orpaltech/dreamstalker/hardware/images/PRO/v2.2/PXL_20260126_130624400.jpg

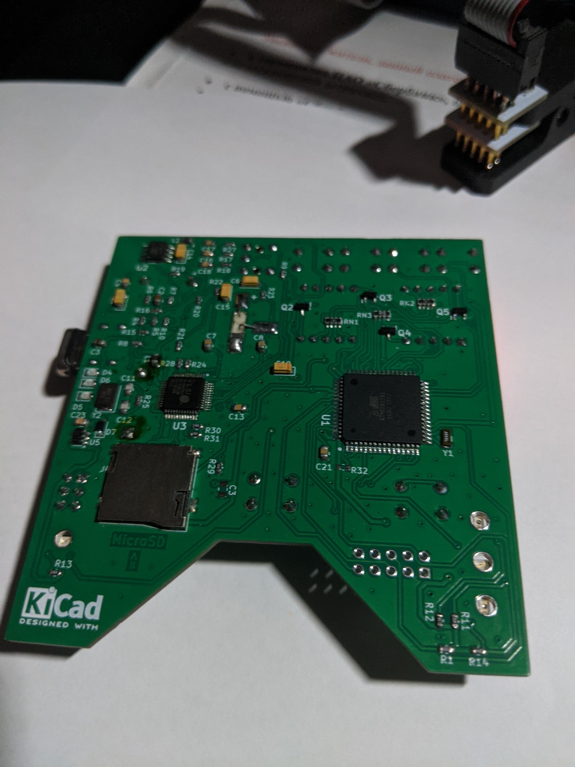
hardware/images/PRO/v2.2/PXL_20260126_130624400.jpg
