orpaltech/dreamstalker/README.md

# dreamstalker

This device is designed to assist with lucid dreaming. The idea comes from this site: https://smartelectron.ru/projects/pribor-dlya-osoznannyh-snovidenij-dreamstalker-pro.
