orpaltech/dreamstalker/hardware/images/PRO/v2.2/PXL_20260126_130629635.jpg

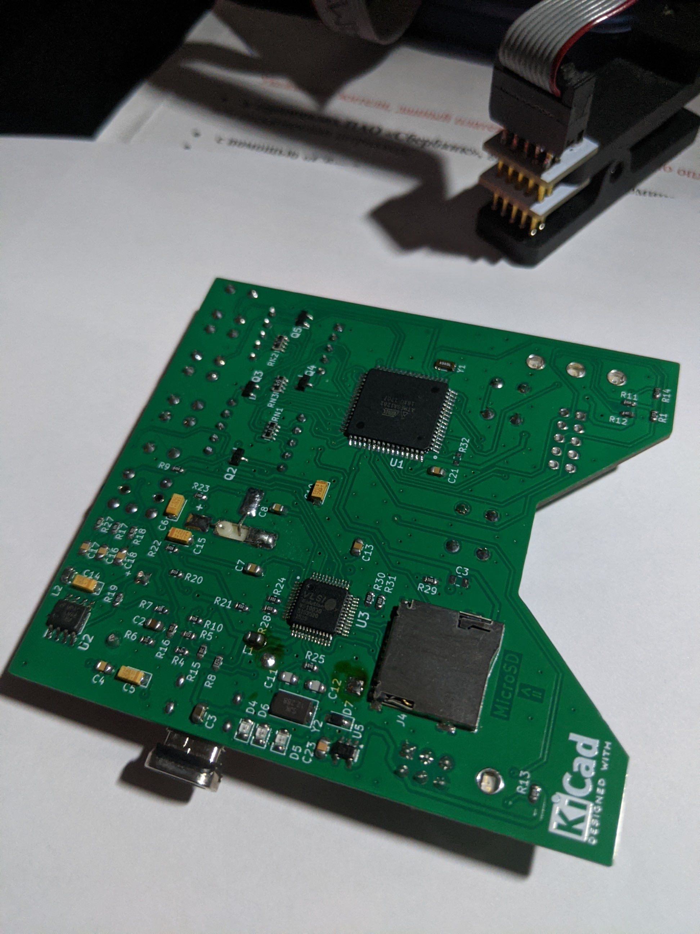
hardware/images/PRO/v2.2/PXL_20260126_130629635.jpg
