orpaltech/dreamstalker/tools/qtdreamflowmanager/images/about.png

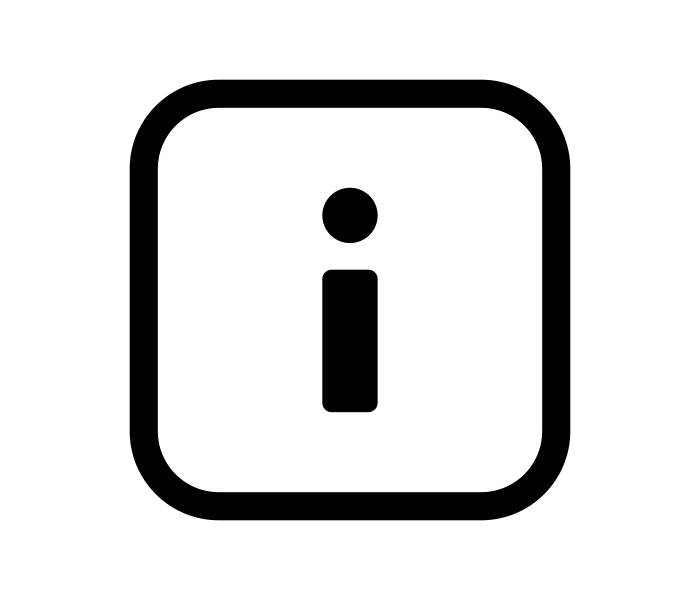
tools/qtdreamflowmanager/images/about.png
