orpaltech/dreamstalker/tools/qtdreamflowmanager/images/application-exit.png

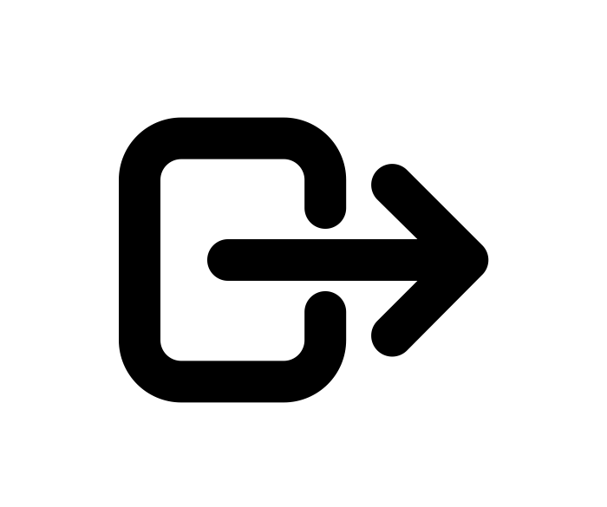
tools/qtdreamflowmanager/images/application-exit.png
