orpaltech/dreamstalker/tools/qtdreamflowmanager/images/line-chart.png

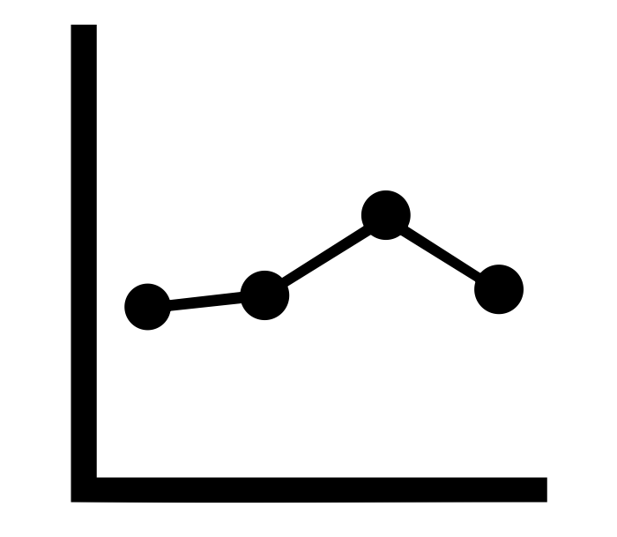
tools/qtdreamflowmanager/images/line-chart.png
