orpaltech/dreamstalker/tools/qtdreamflowmanager/images/load-from-device.png

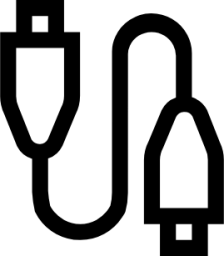
tools/qtdreamflowmanager/images/load-from-device.png
