orpaltech/dreamstalker/hardware/kicad/PRO/Dreamstalker-PRO-v2/Dreamstalker-PRO-v2.kicad_pcb

## KiCad design hardware/kicad/PRO/Dreamstalker-PRO-v2/Dreamstalker-PRO-v2.kicad_pcb (2026-08-15)

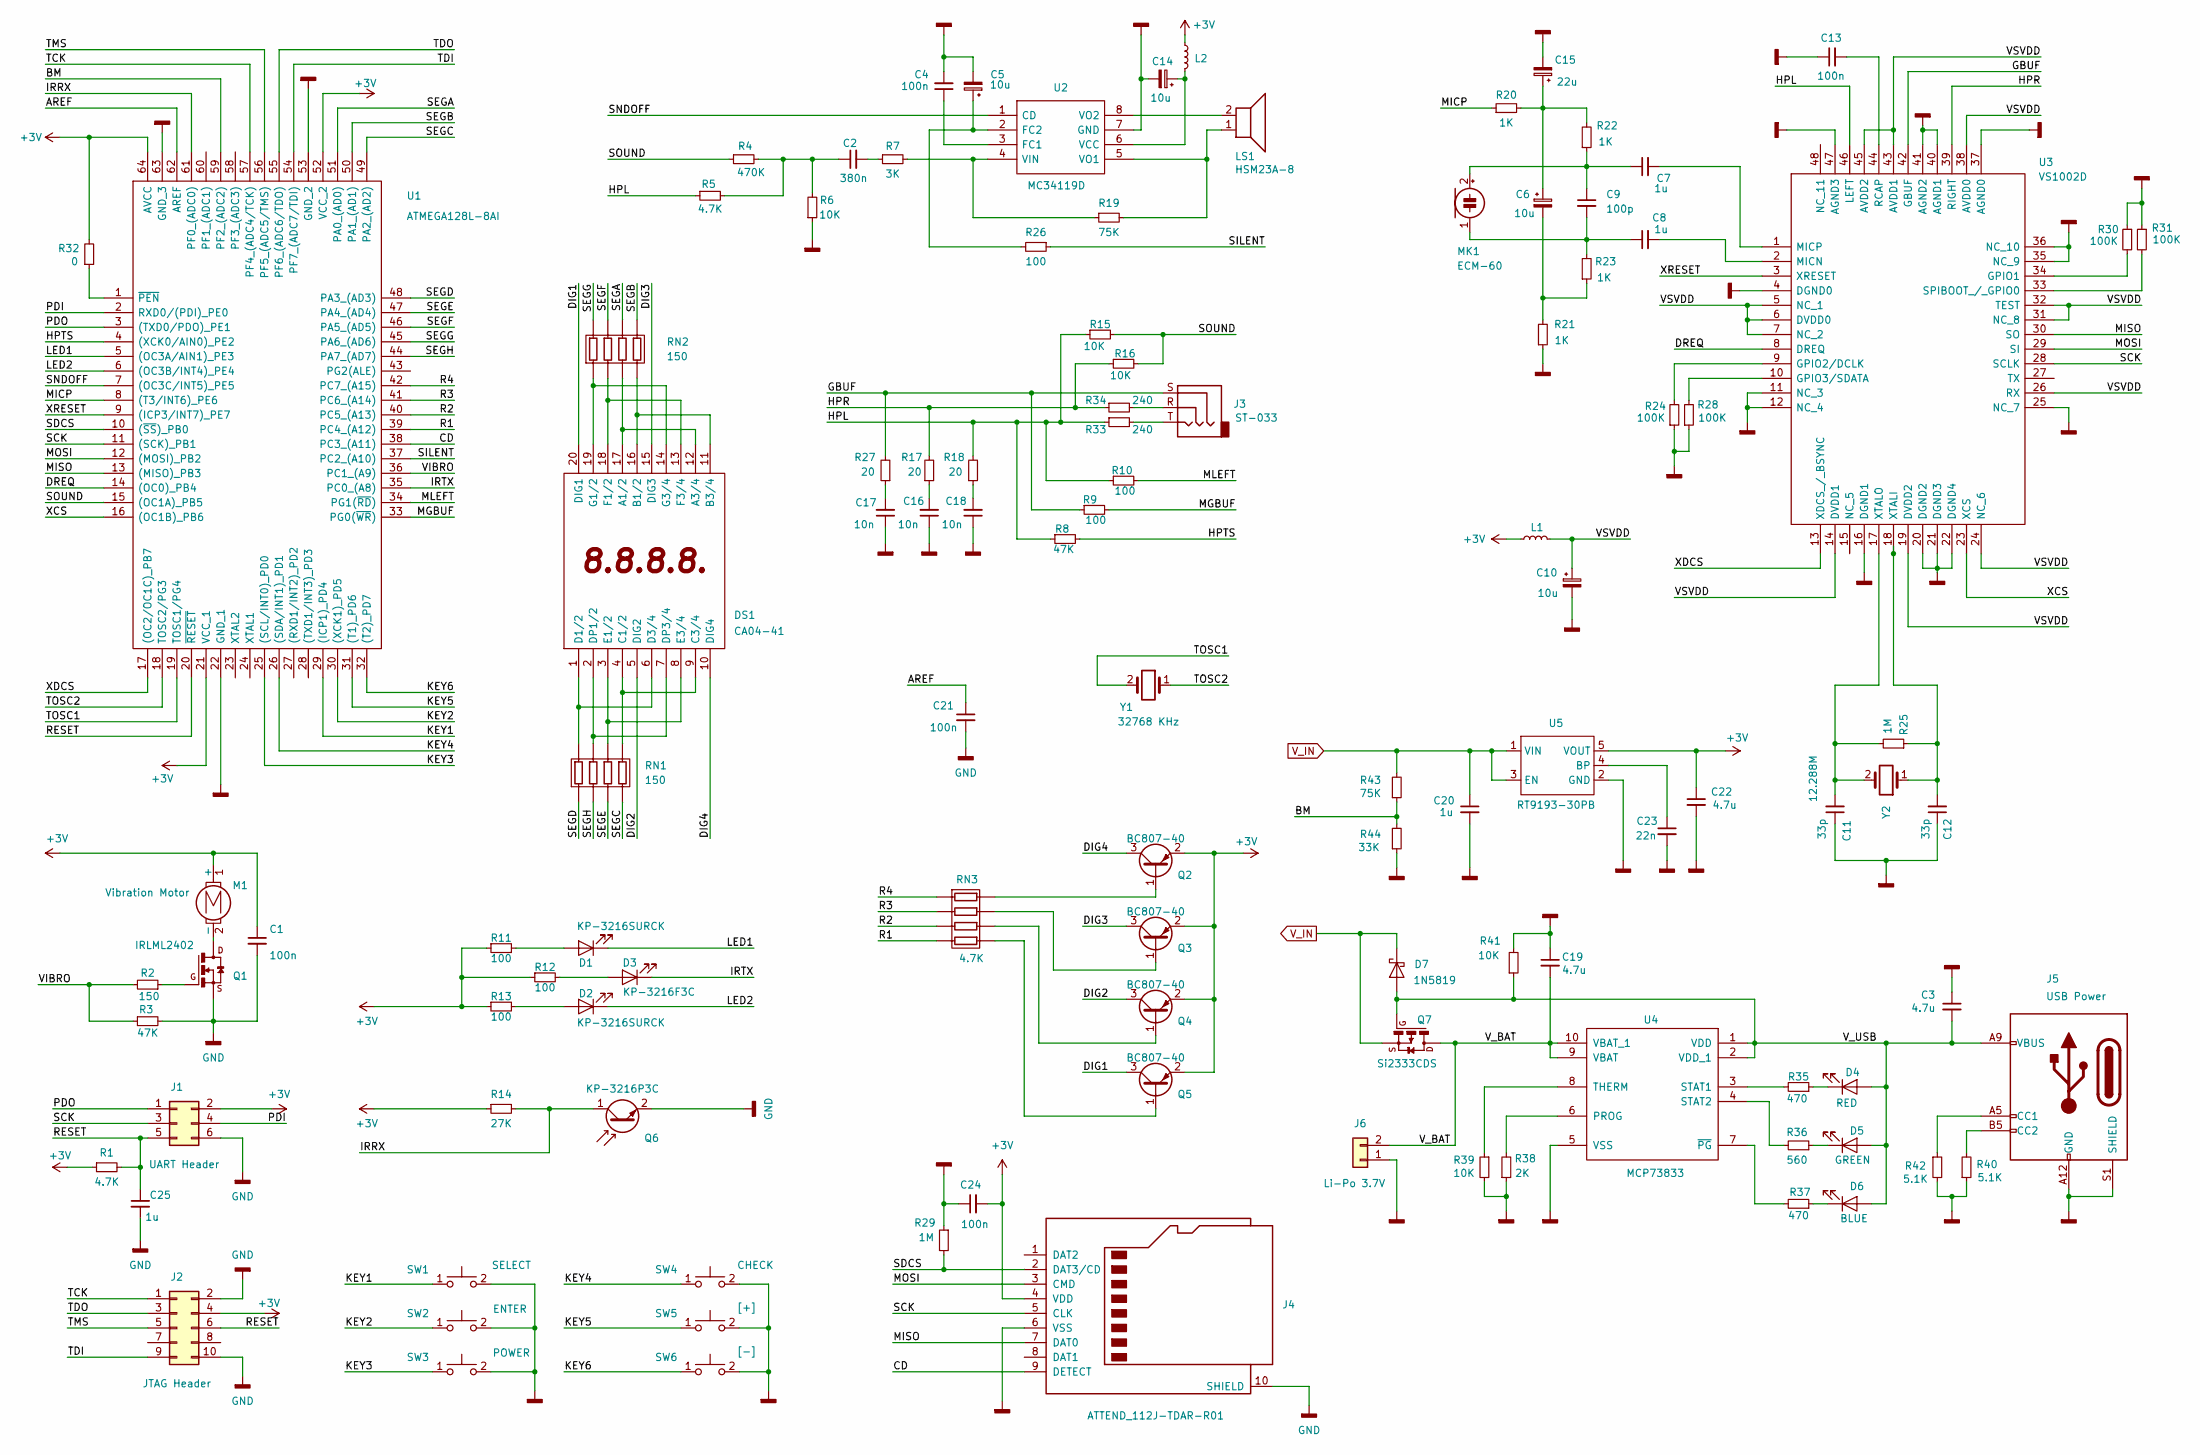
[picture p10: schematic Dreamstalker-PRO-v2.kicad_sch, Dreamstalker PRO]

Parts:
C1, C4, C13, C21, C24: 100n; C_0805_2012Metric
C2: 380n; C_0805_2012Metric
C3, C19, C22: 4.7u; C_0805_2012Metric
C5, C6, C10, C14: 10u; CP_EIA-3216-18_Kemet-A
C7, C8, C20, C25: 1u; C_0805_2012Metric
C9: 100p; C_0805_2012Metric
C11, C12: 33p; C_0805_2012Metric
C15: 22u; CP_EIA-3216-18_Kemet-A
C16, C17, C18: 10n; C_0805_2012Metric
C23: 22n; C_0805_2012Metric
D1, D2: KP-3216SURCK; LEDC3216X110N-TH
D3: KP-3216F3C; LEDC3216X110N-TH
D4: RED; LED_0805_2012Metric
D5: GREEN; LED_0805_2012Metric
D6: BLUE; LED_0805_2012Metric
D7: 1N5819; D_SOD-323_HandSoldering
DS1: CA04-41; Manufacturer_Part_Number CA04-41
J1: UART Header; PinHeader_2x03_P2.54mm_Vertical
J2: JTAG Header; PinHeader_2x05_P2.54mm_Vertical
J3: ST-033; DCI_Phone_Jack_3.5mm_ST-033
J4: ATTEND_112J-TDAR-R01; Manufacturer_Part_Number 112J-TDAR-R01
J5: USB Power; USB_C_Receptacle_GCT_USB4125-xx-x_6P_TopMnt_Horizontal
J6: Li-Po 3.7V; JST_PH_B2B-PH-K_1x02_P2.00mm_Vertical
L1, L2: L_Small; L_0805_2012Metric
LS1: HSM23A-8; Buzzer_23x11.5RM10
M1: Vibration Motor; VIBRO-MOTOR_SMD
MK1: ECM-60; JININ_ELECTRET_CONDENSER_MICROPHONE_ECM-60
Q1: IRLML2402; SOT95P237X112-3N
Q2, Q3, Q4, Q5: BC807-40; SOT95P230X110-3N
Q6: KP-3216P3C; LEDC3216X130N-TH
Q7: Si2333CDS; SOT-23
R1, R5: 4.7K; R_0603_1608Metric
R2: 150; R_0603_1608Metric
R3, R8: 47K; R_0603_1608Metric
R4: 470K; R_0603_1608Metric
R6, R15, R16, R39, R41: 10K; R_0603_1608Metric
R7: 3K; R_0603_1608Metric
R9, R10, R11, R12, R13, R26: 100; R_0603_1608Metric
R14: 27K; R_0603_1608Metric
R17, R18, R27: 20; R_0603_1608Metric
R19, R43: 75K; R_0603_1608Metric
R20, R21, R22, R23: 1K; R_0603_1608Metric
R24, R28, R30, R31: 100K; R_0603_1608Metric
R25, R29: 1M; R_0603_1608Metric
R32: 0; R_0603_1608Metric
R33, R34: 240; R_0603_1608Metric
R35, R37: 470; R_0603_1608Metric
R36: 560; R_0603_1608Metric
R38: 2K; L_0603_1608Metric
R40, R42: 5.1K; R_0603_1608Metric
R44: 33K; R_0603_1608Metric
RN1, RN2: 150; R_Array_Convex_4x0603
RN3: 4.7K; R_Array_Convex_4x0603
SW1: SELECT; SW_PUSH_6mm
SW2: ENTER; SW_PUSH_6mm
SW3: POWER; SW_PUSH_6mm
SW4: CHECK; SW_PUSH_6mm
SW5: [+]; SW_PUSH_6mm
SW6: [-]; SW_PUSH_6mm
U1: ATMEGA128L-8AI; QFP80P1600X1600X120-64N; Manufacturer_Part_Number ATMEGA128L-8AI
U2: MC34119D; SOIC127P600X175-8N; Manufacturer_Part_Number MC34119D
U3: VS1002D; QFP50P900X900X160-48N; Manufacturer_Part_Number VS1002D
U4: MCP73833; SOP50P490X110-10N; Manufacturer_Part_Number MCP73833-FCI/UN
U5: RT9193-30PB; SOT-23-5; Manufacturer_Part_Number RT9193
Y1: 32768 KHz; Crystal_SMD_3215-2Pin_3.2x1.5mm
Y2: 12.288M; Crystal_SMD_5032-2Pin_5.0x3.2mm

Connections:
+3V: C1.1, C22.1, C24.2, J1.2, J2.4, J4.4 (VDD), L1.1, L2.1, M1.1 (+), Q2.2 (E), Q3.2 (E), Q4.2 (E), Q5.2 (E), R1.1, R11.1, R12.1, R13.1, R14.1, R32.2, U1.21 (VCC_1), U1.52 (VCC_2), U1.64 (AVCC), U5.5 (VOUT)
/AREF: C21.1, U1.62 (AREF)
/BM: R43.1, R44.2, U1.59 (PF2_(ADC2))
/CD: J4.9 (DETECT), U1.38 (PC3_(A11))
/DIG1: DS1.20 (DIG1), Q5.3 (C)
/DIG2: DS1.5 (DIG2), Q4.3 (C)
/DIG3: DS1.15 (DIG3), Q3.3 (C)
/DIG4: DS1.10 (DIG4), Q2.3 (C)
/DREQ: U1.14 ((OC0)_PB4), U3.8 (DREQ)
/GBUF: J3.S, R9.1, R27.2, U3.42 (GBUF)
/HPL: R5.1, R8.1, R10.1, R15.1, R18.2, R33.1, U3.46 (LEFT)
/HPR: R16.1, R17.2, R34.1, U3.39 (RIGHT)
/HPTS: R8.2, U1.4 ((XCK0/AIN0)_PE2)
/IRRX: Q6.1 (C), R14.2, U1.61 (PF0_(ADC0))
/IRTX: D3.1 (K), U1.35 (PC0_(A8))
/KEY1: SW1.1, U1.29 ((ICP1)_PD4)
/KEY2: SW2.1, U1.30 ((XCK1)_PD5)
/KEY3: SW3.1, U1.25 ((SCL/INT0)_PD0)
/KEY4: SW4.1, U1.26 ((SDA/INT1)_PD1)
/KEY5: SW5.1, U1.31 ((T1)_PD6)
/KEY6: SW6.1, U1.32 ((T2)_PD7)
/LED1: D1.1 (K), U1.5 ((OC3A/AIN1)_PE3)
/LED2: D2.1 (K), U1.6 ((OC3B/INT4)_PE4)
/MGBUF: R9.2, U1.33 (PG0(~WR))
/MICP: R20.1, U1.8 ((T3/INT6)_PE6)
/MISO: J4.7 (DAT0), U1.13 ((MISO)_PB3), U3.30 (SO)
/MLEFT: R10.2, U1.34 (PG1(~RD))
/MOSI: J4.3 (CMD), U1.12 ((MOSI)_PB2), U3.29 (SI)
/PDI: J1.4, U1.2 (RXD0/(PDI)_PE0)
/PDO: J1.1, U1.3 ((TXD0/PDO)_PE1)
/R1: RN3.4 (R4.1), U1.39 (PC4_(A12))
/R2: RN3.3 (R3.1), U1.40 (PC5_(A13))
/R3: RN3.2 (R2.1), U1.41 (PC6_(A14))
/R4: RN3.1 (R1.1), U1.42 (PC7_(A15))
/RESET: C25.1, J1.5, J2.6, R1.2, U1.20 (~RESET)
/SCK: J1.3, J4.5 (CLK), U1.11 ((SCK)_PB1), U3.28 (SCLK)
/SDCS: J4.2 (DAT3/CD), R29.2, U1.10 ((~SS)_PB0)
/SEGA: RN2.6 (R3.2), U1.51 (PA0_(AD0))
/SEGB: RN2.5 (R4.2), U1.50 (PA1_(AD1))
/SEGC: RN1.4 (R4.1), U1.49 (PA2_(AD2))
/SEGD: RN1.1 (R1.1), U1.48 (PA3_(AD3))
/SEGE: RN1.3 (R3.1), U1.47 (PA4_(AD4))
/SEGF: RN2.7 (R2.2), U1.46 (PA5_(AD5))
/SEGG: RN2.8 (R1.2), U1.45 (PA6_(AD6))
/SEGH: RN1.2 (R2.1), U1.44 (PA7_(AD7))
/SILENT: R26.1, U1.37 (PC2_(A10))
/SNDOFF: U1.7 ((OC3C/INT5)_PE5), U2.1 (CD)
/SOUND: R4.1, R15.2, R16.2, U1.15 ((OC1A)_PB5)
/TCK: J2.1, U1.57 (PF4_(ADC4/TCK))
/TDI: J2.9, U1.54 (PF7_(ADC7/TDI))
/TDO: J2.3, U1.55 (PF6_(ADC6/TDO))
/TMS: J2.5, U1.56 (PF5_(ADC5/TMS))
/TOSC1: U1.19 (TOSC1/PG4), Y1.2
/TOSC2: U1.18 (TOSC2/PG3), Y1.1
/VIBRO: R2.2, R3.1, U1.36 (PC1_(A9))
/VSVDD: C10.1, L1.2, U3.5 (NC_1), U3.6 (DVDD0), U3.7 (NC_2), U3.14 (DVDD1), U3.19 (DVDD2), U3.24 (NC_6), U3.26 (RX), U3.31 (NC_8), U3.32 (TEST), U3.38 (AVDD0), U3.43 (AVDD1), U3.45 (AVDD2)
/V_BAT: C19.2, J6.2, Q7.3 (D), U4.9 (VBAT), U4.10 (VBAT_1)
/V_USB: C3.2, D4.2 (A), D5.2 (A), D6.2 (A), D7.2 (A), J5.A9 (VBUS), J5.B9 (VBUS), Q7.1 (G), R41.1, U4.1 (VDD), U4.2 (VDD_1)
/XCS: U1.16 ((OC1B)_PB6), U3.23 (XCS)
/XDCS: U1.17 ((OC2/OC1C)_PB7), U3.13 (XDCS_/_BSYNC)
/XRESET: U1.9 ((ICP3/INT7)_PE7), U3.3 (XRESET)
GND: C1.2, C3.1, C4.2, C5.2, C10.2, C11.1, C12.1, C13.1, C14.2, C15.2, C16.1, C17.1, C18.1, C19.1, C20.2, C21.2, C22.2, C23.2, C24.1, C25.2, J1.6, J2.2, J2.10, J4.6 (VSS), J4.10 (SHIELD), J5.A12 (GND), J5.B12 (GND), J5.S1 (SHIELD), J6.1, Q1.2 (S), Q6.2 (E), R3.2, R6.1, R21.1, R24.1, R28.1, R29.1, R30.1, R31.1, R38.1, R39.2, R40.1, R41.2, R42.2, R44.1, SW1.2, SW2.2, SW3.2, SW4.2, SW5.2, SW6.2, U1.22 (GND_1), U1.53 (GND_2), U1.63 (GND_3), U2.7 (GND), U3.4 (DGND0), U3.11 (NC_3), U3.12 (NC_4), U3.16 (DGND1), U3.20 (DGND2), U3.21 (DGND3), U3.22 (DGND4), U3.25 (NC_7), U3.35 (NC_9), U3.36 (NC_10), U3.37 (AGND0), U3.40 (AGND1), U3.41 (AGND2), U3.47 (AGND3), U4.5 (VSS), U5.2 (GND)
unnamed: C2.1, R4.2, R5.2, R6.2
unnamed: C2.2, R7.1
unnamed: C6.2, R21.2, R23.1
unnamed: C6.1, C15.1, R20.2, R22.2
unnamed: C16.2, R17.1
unnamed: C17.2, R27.1
unnamed: C18.2, R18.1
unnamed: D1.2 (A), R11.2
unnamed: D2.2 (A), R13.2
unnamed: D3.2 (A), R12.2
unnamed: D4.1 (K), R35.1
unnamed: D5.1 (K), R36.1
unnamed: D6.1 (K), R37.1
unnamed: DS1.12 (A3/4), DS1.17 (A1/2), RN2.3 (R3.1)
unnamed: DS1.11 (B3/4), DS1.16 (B1/2), RN2.4 (R4.1)
unnamed: DS1.4 (C1/2), DS1.9 (C3/4), RN1.5 (R4.2)
unnamed: DS1.1 (D1/2), DS1.6 (D3/4), RN1.8 (R1.2)
unnamed: DS1.2 (DP1/2), DS1.7 (DP3/4), RN1.7 (R2.2)
unnamed: DS1.3 (E1/2), DS1.8 (E3/4), RN1.6 (R3.2)
unnamed: DS1.13 (F3/4), DS1.18 (F1/2), RN2.2 (R2.1)
unnamed: DS1.14 (G3/4), DS1.19 (G1/2), RN2.1 (R1.1)
unnamed: J3.R, R34.2
unnamed: J3.T, R33.2
unnamed: J5.A5 (CC1), R42.1
unnamed: J5.B5 (CC2), R40.2
unnamed: M1.2 (-), Q1.3 (D)
unnamed: C7.1, C9.1, MK1.2 (+), R22.1
unnamed: C8.1, C9.2, MK1.1 (-), R23.2
unnamed: Q1.1 (G), R2.1
unnamed: Q2.1 (B), RN3.8 (R1.2)
unnamed: Q3.1 (B), RN3.7 (R2.2)
unnamed: Q4.1 (B), RN3.6 (R3.2)
unnamed: Q5.1 (B), RN3.5 (R4.2)
unnamed: R32.1, U1.1 (~PEN)
unnamed: C4.1, U2.3 (FC1)
unnamed: C5.1, R26.2, U2.2 (FC2)
unnamed: C14.1, L2.2, U2.6 (VCC)
unnamed: R7.2, R19.1, U2.4 (VIN)
unnamed: LS1.1, R19.2, U2.5 (VO1)
unnamed: LS1.2, U2.8 (VO2)
unnamed: R30.2, U3.34 (GPIO1)
unnamed: R24.2, U3.9 (GPIO2/DCLK)
unnamed: R28.2, U3.10 (GPIO3/SDATA)
unnamed: C8.2, U3.2 (MICN)
unnamed: C7.2, U3.1 (MICP)
unnamed: C13.2, U3.44 (RCAP)
unnamed: R31.2, U3.33 (SPIBOOT_/_GPIO0)
unnamed: C12.2, R25.1, U3.18 (XTALI), Y2.1
unnamed: C11.2, R25.2, U3.17 (XTALO), Y2.2
unnamed: R38.2, U4.6 (PROG)
unnamed: R35.2, U4.3 (STAT1)
unnamed: R36.2, U4.4 (STAT2)
unnamed: R39.1, U4.8 (THERM)
unnamed: R37.2, U4.7 (~PG)
unnamed: C23.1, U5.4 (BP)
V_IN: C20.1, D7.1 (K), Q7.2 (S), R43.2, U5.1 (VIN), U5.3 (EN)

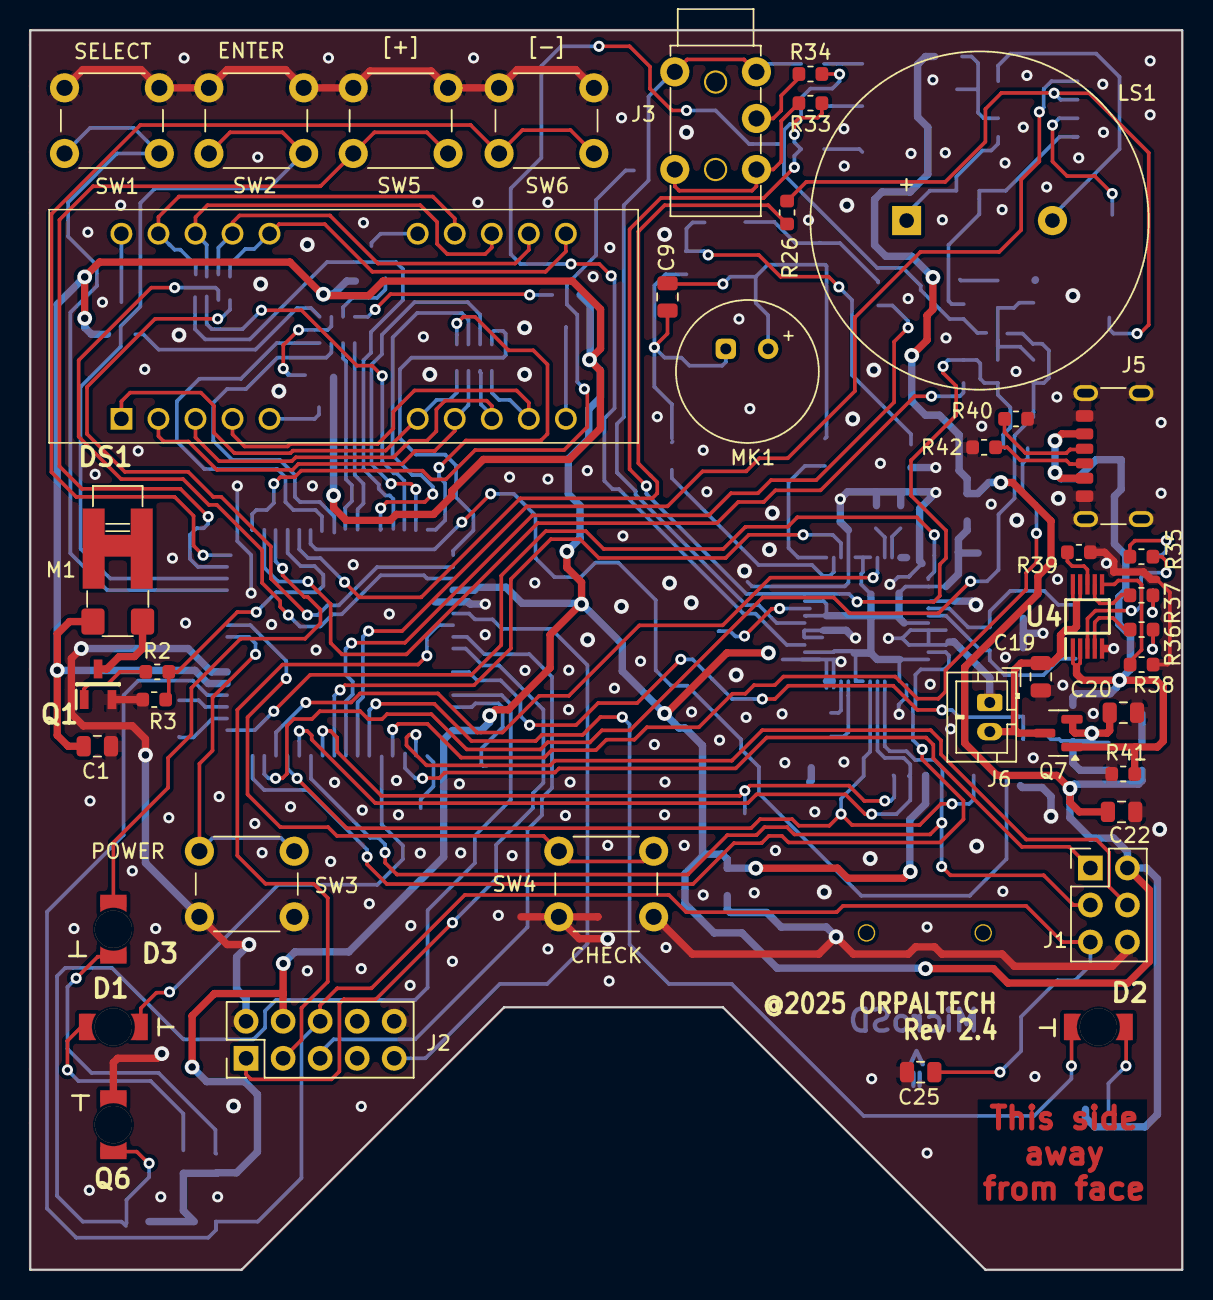
[picture p11: board Dreamstalker-PRO-v2.kicad_pcb from above]

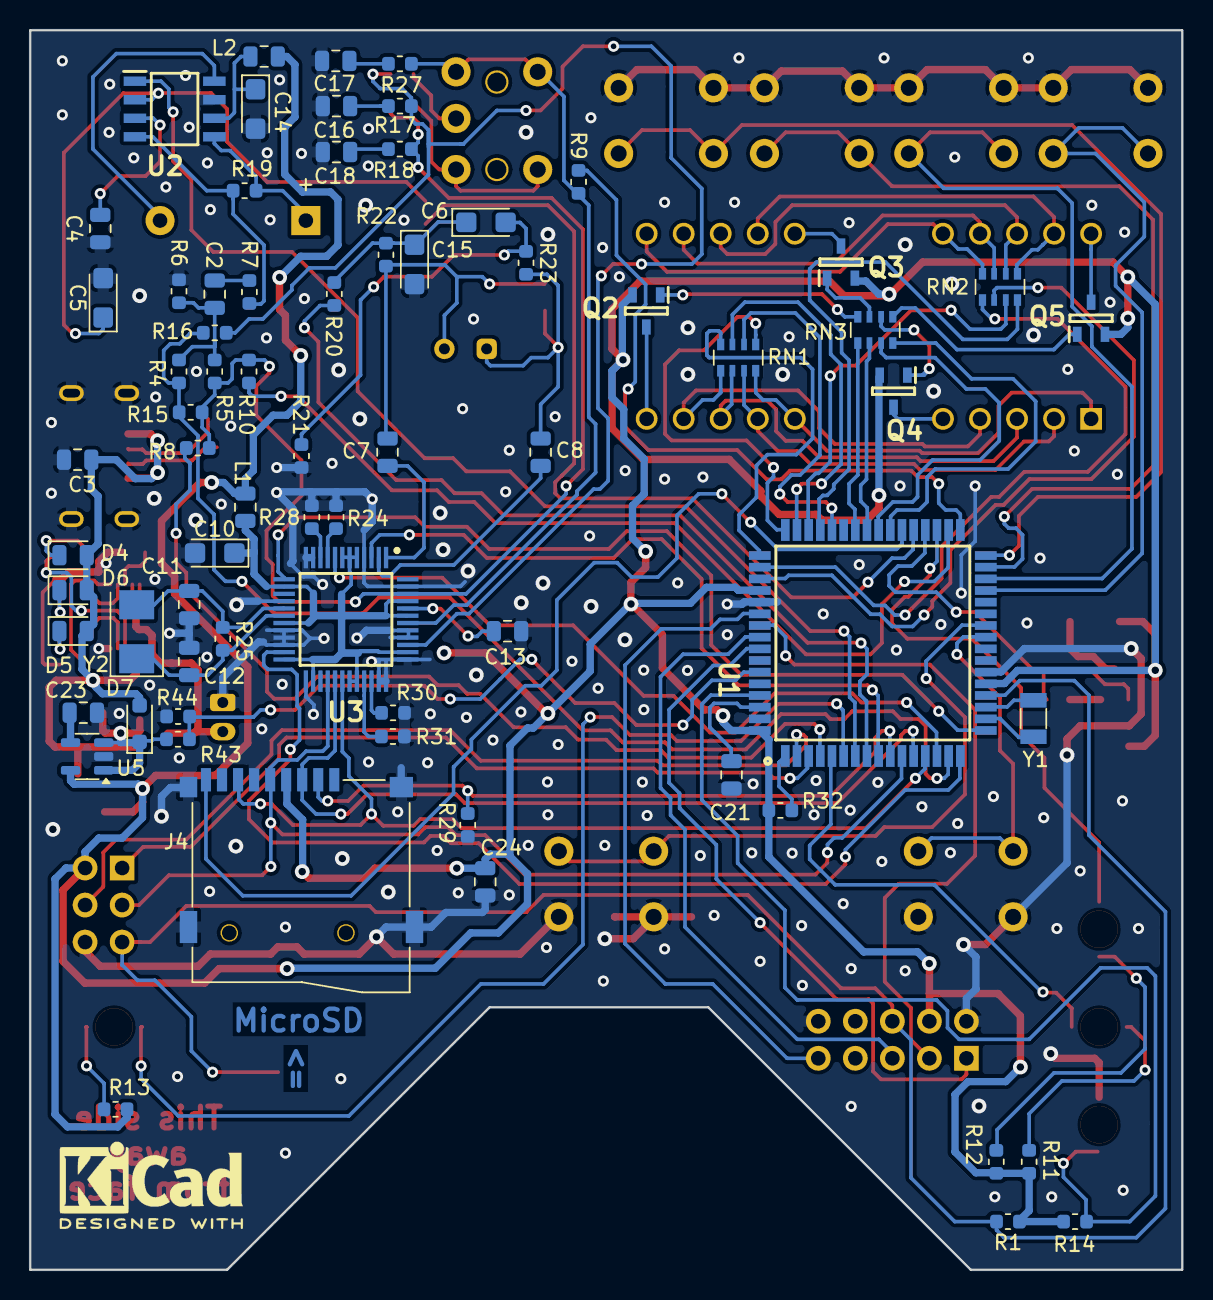
[picture p12: board Dreamstalker-PRO-v2.kicad_pcb from below]

Board: 2 copper layers, 79.0 x 85.0 mm, 111 parts (70 on the bottom side), 118 nets.
