orpaltech/dreamstalker/firmware/avrdreamstalkerpro/src/main.cpp

/*
 * This file is part of the AVR Dreamstalker software
 * (https://github.com/orpaltech/dreamstalker).
 *
 * Copyright (c) 2013-2026	ORPAL Technologies, Inc.
 *
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
 * You should have received a copy of the GNU General Public License
 * along with this program. If not, see <http://www.gnu.org/licenses/>.
 */

#include "ds_driver.h"

/*-----------------------------------------------------------------------*/
// put function declarations here:

/*-----------------------------------------------------------------------*/
void setup()
{
  auto drv = ds::Driver::get();

  // put your setup code here, to run once

  if (! drv->init ())
    return;

  if (! drv->start () )
  {
    // Handle the critical error
    drv->reboot_on_key ();
  }
}

/*-----------------------------------------------------------------------*/
void loop()
{
  auto drv = ds::Driver::get();

  drv->process ();

  /* End of app loop */
  _NOP ();
}
