orpaltech/dreamstalker/firmware/avrdreamstalkerpro/src/ds_driver.cpp

/*
 * This file is part of the AVR Dreamstalker software
 * (https://github.com/orpaltech/dreamstalker).
 *
 * Copyright (c) 2013-2025	ORPAL Technologies, Inc.
 *
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
 * You should have received a copy of the GNU General Public License
 * along with this program. If not, see <http://www.gnu.org/licenses/>.
 */

#include <Arduino.h>

#include <avr/io.h>
#include <compat/ina90.h>
#include <util/atomic.h>

#include "ds_driver.h"
#include "ds_config.h"
#include "ds_rtclock.h"
#include "display/ds_display.h"
#include "display/ds_disp_msgs.h"
#include "sound/ds_sound.h"
#include "sound/ds_codec.h"
#include "ds_remdetect.h"
#include "ds_battery.h"
#include "input/ds_keybrd.h"
#include "ds_appmenu.h"
#include "ds_sqwave.h"
#include "ds_sysclock.h"
#include "ds_vibro.h"
#include "ds_remhints.h"
#include "ds_sdfat.h"

using namespace avr::core;

/*-----------------------------------------------------------------------*/

/*
 * Defines the key to exit from sleep mode
 */
#define KEY_EXIT_SLEEP  KEY_POWER

namespace ds
{
/*-----------------------------------------------------------------------*/
void key_tone (bool wait = false)
{
  uint16_t duration = 80;
  Tonegen::get()->beep ( duration, 3, 6, Config::get()->get_volume_level ());
  
  if ( wait ) {
    SysClock::get()->wait (duration);
  }
}


/*-----------------------------------------------------------------------*/
Driver *Driver::get()
{
  static Driver instance;
  return &instance;
}

/*-----------------------------------------------------------------------*/
void Driver::alarm_clock_callback (void *context)
{
  Driver *pdrv = static_cast<Driver *>(context);

  pdrv->on_alarm_clock ();
}

void Driver::wakeup_timer_callback (void *context)
{
  Driver *pdrv = static_cast<Driver *>(context);

  pdrv->on_wakeup_timer ();
}

void Driver::remd_callback (void *context, remd::remd_event_type_t event, uint16_t arg)
{
  Driver *pdrv = static_cast<Driver *>(context);

  if ( pdrv->is_remd_check () ) {

    // REMD testing mode 

    if ( event == remd::REMD_EVENT_MOVE ) {
      Tonegen::get()->beep(50, 4, 7, Config::get()->get_volume_level ());
    }

  }
  else {
    
    // REMD lucid dreaming mode

    if ( event == remd::REMD_EVENT_REM ) {
      pdrv->on_remd_event_rem( arg );
    }
  }
}

/*-----------------------------------------------------------------------*/
#if RUN_TEST_MODE

bool Driver::begin (void)
{
  delay(600); /* Let power stabilize */

  set_mode ( OPM_NONE );

  RTClock::get()->init();
  SysClock::get()->init();
  Display::get()->init();
  Keyboard::get()->init ();
  AppMenu::get()->init();
  SquareWave::get()->init();
  Leds::get()->init();
  VibroMotor::get()->init();
  Sound::get()->init ();
  REMDetect::get()->init();
  BatteryMonitor::get()->init();

  return true;
}

void Driver::end (void)
{
  // Implement , if needed
}

bool Driver::start (void)
{
  set_mode ( OPM_NORMAL );    /* Start in normal mode */

  interrupts();   /* Enable interrupts globally */

  /* Disable hold-repeat keyboard feature by default */
  //Keyboard::get()->hold_repeat_disable ();

  /* IMPORTANT: Real-Time clock is the core component (!)
   *            Most of the other components will NOT work 
   *            without it.
   */
  RTClock::get()->start ();   /* Start real-time clock.*/ 

  SysClock::get()->start ();

  delay(1000);

  /////////
  VibroMotor::get()->start(6, 1000);
  delay(1000);
  /////////

  /*if (card0.begin ())
  {
     /////////
    Vibro::get()->start(5, 1000);
    delay(1000);
    /////////
  }*/


  Leds::get()->on(DS::LED1, 50, 0);
  Leds::get()->on(DS::LED2, 80, 0);

  Sound::get()->start();

  //Tonegen::get()->play_melody(TGP_FUR_ELISE, 1);


  return true;
}

void Driver::stop (void)
{
  noInterrupts();

  set_mode ( OPM_NONE );

  // TODO: implement, if needed
}

void Driver::process (void)
{

  delay (1000);

  key_tone ();

}

#else

bool Driver::init (void)
{
  delay(500); /* Let power stabilize */

  // Set member variables
  remd_check = false;

  set_mode ( OperationMode::None );

  // Initialize all subsystems
  SdFatEx::get()->init();
  RTClock::get()->init();
  SysClock::get()->init();
  Display::get()->init();
  Keyboard::get()->init ();
  AppMenu::get()->init();
  SquareWave::get()->init();
  VibroMotor::get()->init();
  remd::Lights::get()->init();
  Sound::get()->init ();
  remd::Detector::get()->init();
  Battery::get()->init();
  

#if ((REMD_LOG == REMD_LOG_SERIAL) || BATTMON_TEST)
  Serial.begin( UART0_BITRATE );
  while (!Serial) {
    _NOP(); // wait for serial port to connect
  }
#endif

  return true;
}

void Driver::end (void)
{
  // Implement , if needed
}

bool Driver::start (void)
{
  bool success = true;
  char msg[ 5 ];
  auto disp = Display::get();

  set_mode ( OperationMode::Normal );    /* Start in normal mode */

  interrupts();   /* Enable interrupts globally */

  /* Disable hold-repeat keyboard feature by default */
  Keyboard::get()->hold_repeat_disable ();

  RTClock::get()->start();   /* Start real-time clock.*/ 

  /* IMPORTANT: System clock is the core component (!)
   *            Most of the other components will NOT work 
   *            without it.
   */
  SysClock::get()->start ();

  disp->enable ();
  disp->version ('P', fw_version(), 1000);


  /* SD-card initialization */
  SdFile::dateTimeCallback(RTClock::fat_datetime);

#if USE_SDFAT_LIB
  SdSpiConfig sd_spi(SS, SHARED_SPI, SD_SCK_MHZ(4));

  while (! (SdFatEx::get()->is_card_inserted() && SdFatEx::get()->sd0.begin (sd_spi))) {
#else
  while (! (SdFatEx::get()->is_card_inserted() && SdFatEx::get()->sd0.begin ())) {
#endif

    /* handle error */
    disp->message (__disp_msg_no_sd__, 1);

    /* let user insert SD-card and press ON/OFF */
    Keyboard::get()->wait_for_key_press ( KEY_POWER );

    /* try SD-card again...*/
    disp->message (__disp_msg_all_dots__, 500);
  }

   /* SD-card found */
  disp->message (__disp_msg_sd_0__, 1000);
  

  do {
    if ( ! AudioCodec::get()->init () ) {

      // codec initialization failed!
      disp->message (__disp_msg_codec_error__, 1);

      success = false;
      break;
    }

    /* Display codec version */
    snprintf ( msg, 5, __disp_msg_codec_spec__, VS_HW_SPEC );
    disp->message ( msg, 1000 );


    if ( ! Config::get()->begin () ) {

      // initialization failed!

      success = false;
      break;
    }

    /* NOTE: The following initialization require 
    *       the config to be loaded prior 
    */
    /* ... */

    RTClock::get()->show ();

    A2DConvert::get()->enable ();
    A2DConvert::get()->warm_up ();
    Battery::get()->start();

    Sound::get()->start();

  } while ( false );

  Keyboard::get()->clear_events ();

  return success;
}

void Driver::stop (void)
{
  noInterrupts();

  set_mode ( OperationMode::None );

  // TODO: implement, if needed
}

void Driver::process (void)
{
  int ret;
  keybrd_event_t key_event;

  // put your main code here, to run repeatedly:

  /* check to see if user has pressed a button */
  key_event = Keyboard::get()->get_event ();

  if ( AppMenu::get()->is_active () && ( key_event != KEY_NONE )) {

    ret = AppMenu::get()->handle_key( key_event );
    if ( ret & MENU_HANDLED ) {

      if ( ret & MENU_EXIT ) {

        // Exit from menu, show the clock again
        RTClock::get()->show ();
      }

      // Event has been processed by menu 
      key_event = KEY_NONE;
    }
  }


  switch ( key_event ) {

    case ( KEY_ENTER | KEY_MINUS | KEYBRD_HOLD ): 
    case ( KEY_ENTER | KEY_PLUS | KEYBRD_HOLD ): {
      key_tone ();
      wakeup_timer_quick_set ( key_event );
      break;
    }

    case ( KEY_SELECT | KEYBRD_HOLD ): {
      key_tone ();

      RTClock::get()->hide ();

      AppMenu::get()->enter ();

      break;
    }

    case ( KEY_POWER | KEYBRD_HOLD ): {
      key_tone ();

      power_off ();

      break;
    }

    case ( KEY_CHECK ): {
      key_tone ();

      // Temporarily use this button to stop REM detector
      stop_lucid_dream ();
      
#if REMD_TEST
      
      if ( is_lucid_dreaming () ) {

        stop_lucid_dream ();
      } else {

        start_lucid_dream ();
      }

#elif RECORD_TEST
      String filepath;
      Files::make_next_file_path(filepath, RECORDS_PATH, "REC", "WAV", 5);
      
      auto codec = AudioCodec::get();
      if (codec->get_state() == AudioCodec::STATE_NONE) {

        key_tone (true);

        codec->capture (filepath.c_str());
      } else {

        codec->stop ();

        key_tone ();
      }

#elif TONEGEN_TEST
      if (Tonegen::get()->is_playing () )
        Tonegen::get()->stop ();

      else {
        delay (100);
        Tonegen::get()->play_melody(DS::TGP_KLEINE_NACHTMUSIK, 1);
      }

#elif VIBRO_TEST
      if ( vibro.is_running () ) {
        vibro.stop();

      } else {
        vibro.start(4, 0);

      }
#endif

      break;
    }

  }

  /*
   * Process different tasks
   */
  RTClock::get()->process_task ();
  remd::Detector::get()->process_task ();
  AudioCodec::get()->process_task ();

}
#endif

void Driver::reboot_on_key (void)
{
  /* let user press ON/OFF */
  Keyboard::get()->wait_for_key_press (KEY_POWER);

  // and reboot
  soft_reset ();
}

void Driver::remd_start_check (void)
{
  auto remd = remd::Detector::get();

  if ( remd_check )
    return;

  if ( !remd->start (remd_callback, this, true)) {
    return;
  }

  remd_check = true;
}

void Driver::remd_stop_check (void)
{
  auto remd = remd::Detector::get();

  if (! remd_check )
    return;

  remd->stop ();
  remd_check = false;
}

void Driver::on_wakeup_timer (void)
{
  start_lucid_dream ();
}

void Driver::on_alarm_clock (void)
{

}

void Driver::on_remd_event_rem (uint8_t intensity)
{
  auto clk = RTClock::get();

  if ( remd_check )
    return; // Check mode

  // TODO: do actions on REM detected
  // серию вспышек и звуков во время сновидения

  // Trigger both eyes with a dream-inducing fade
#if REMD_USE_CONFIG_BRIGHTNESS
  intensity = Config::level_to_percent (config.get_light_hints_brightness ());
#endif

  remd::Hints::get()->start (intensity);


  /* Сheck if alarm clock is enabled */
  if (Config::get()->get_alarm_clock_enabled ()) {
    
    clk->alarm_clock_set (alarm_clock_callback, this);
  }

}

void Driver::set_mode (OperationMode mode)
{
  opmode = static_cast<uint8_t>(mode);
}

void Driver::wakeup_timer_toggle (void)
{
  auto clk = RTClock::get();

  if (clk->wakeup_timer_is_set ()) {

    clk->wakeup_timer_cancel ();

  } else {

    clk->wakeup_timer_set (wakeup_timer_callback, this);
  }
}

void Driver::wakeup_timer_quick_set (keybrd_event_t key_event)
{
  auto clk = RTClock::get();
  auto disp = Display::get();

  /* Wake-Up timer */
  if ( clk->wakeup_timer_is_set ()) {

    clk->wakeup_timer_cancel ();
    return;
  }

  clk->hide();
  disp->message ( __disp_msg_set__, 500 );

  if ( key_event & KEY_MINUS ) {
    Config::get()->set_wakeup_timer_delay ( 20 );
    disp->time ( 0, 20 );

  } else {
    Config::get()->set_wakeup_timer_delay ( WAKEUP_TIMER_DELAY_DEFAULT );
    disp->time ( 0, WAKEUP_TIMER_DELAY_DEFAULT );
  }
  SysClock::get()->wait ( 800 );

  clk->wakeup_timer_set (wakeup_timer_callback, this);
  clk->show();
}

#if REMD_TEST
static volatile int16_t remd_test_ticks = -1;
#define REMD_TEST_SECONDS  60UL
#endif

void Driver::handle_sysclk (void)
{
#if REMD_TEST
  if (remd_test_ticks < 0)
    return;

  remd_test_ticks = (remd_test_ticks + 1) % REMD_TEST_SECONDS;
  if (remd_test_ticks == 0)
  {
    // timer went off
    remd_test_ticks = -1;

    REMDetect::get()->stop_unsafe ();

    Tonegen::get()->beep_unsafe(50, 4, 7, config.get_volume_level ());
  }
#endif
}

void Driver::start_lucid_dream (void)
{
  auto remd = remd::Detector::get();

  if ( !remd->start (remd_callback, this, false)) {
    return;
  }

#if REMD_TEST
  /* Set time, stop after REMD_TEST_SECONDS */
  remd_test_ticks = 0;
#endif
}

void Driver::stop_lucid_dream (void)
{
  if (! is_lucid_dreaming ()) return;

  auto *remd = remd::Detector::get();
  remd->stop();

#if REMD_TEST
  remd_test_ticks = -1;
#endif
}

bool Driver::is_lucid_dreaming (void) const
{
  auto *remd = remd::Detector::get();

  return remd->get_state () == remd::Detector::State::On;
}

void Driver::power_off (void)
{
  auto *disp = Display::get();

  RTClock::get()->hide ();
  disp->message (__disp_msg_off__, 500);
  disp->disable ();

  AudioCodec::get()->stop ();
  Battery::get()->stop ();
  remd::Detector::get()->stop();
  A2DConvert::get()->disable ();

  Sound::get()->stop();

  // Stop the system clock
  SysClock::get()->stop ();

  // Set power-saving mode
  set_mode( OperationMode::PowerSave );
  Keyboard::get()->enable_key_irq ( KEY_EXIT_SLEEP );

  /*
   * Go to sleep...
   */
  set_sleep_mode ( SLEEP_MODE_IDLE );

  do {
	  /*
	   * ...Zzz...  
	   */
	  sleep_mode ();
  }
  while (! (Keyboard::get()->get_irq_keys() & KEY_EXIT_SLEEP));

  // Set normal power mode
  set_mode( OperationMode::Normal );
  Keyboard::get()->disable_key_irq ( KEY_EXIT_SLEEP );

  // Start the system clock, since it was stopped during sleep
  SysClock::get()->start ();

  disp->enable ();
  disp->message (__disp_msg_on__, 500);

  RTClock::get()->show ();

  A2DConvert::get()->enable ();
  Battery::get()->start ();

  Sound::get()->start();

  /* Ignore keyboard events that might happen*/
  Keyboard::get()->clear_events ();
}

/*-----------------------------------------------------------------------*/
} //namespace ds
