orpaltech/dreamstalker/firmware/avrdreamstalkerpro/src/ds_appmenu.cpp

/*
 * This file is part of the AVR Dreamstalker software
 * (https://github.com/orpaltech/dreamstalker).
 *
 * Copyright (c) 2013-2026	ORPAL Technologies, Inc.
 *
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
 * You should have received a copy of the GNU General Public License
 * along with this program. If not, see <http://www.gnu.org/licenses/>.
 */

#include <stddef.h>
#include <stdio.h>
#include <stdlib.h>
#include <string.h>
#include <avr/io.h>
#include <avr/pgmspace.h>

#include "input/ds_keybrd.h"
#include "display/ds_display.h"
#include "display/ds_disp_msgs.h"
#include "sound/ds_sound.h"
#include "sound/ds_codec.h"
#include "ds_vibro.h"
#include "ds_config.h"
#include "ds_rtclock.h"
#include "ds_appmenu.h"
#include "ds_driver.h"
#include "ds_util.h"
#include "ds_sdfat.h"


/*-----------------------------------------------------------------------*/

#define MENU_LABEL_LEN	7
#define MENU_INVALID_LEVEL	(-1)

/*-----------------------------------------------------------------------*/
#define MENU_NUMERIC_PROPERTY_SETUP(setup, property, ctx, key_event)	\
  switch ( key_event ) {												\
	case ( KEY_MINUS ):													\
	case ( KEY_MINUS | KEYBRD_HOLD ):									\
	  DSCONF_DECREMENT_PROPERTY(Config::get(), property);				\
	  Display::get()->number ( setup ## _setup_read_value ());			\
	  set_handled (ctx);												\
	  break;															\
	  																	\
	case ( KEY_PLUS ):													\
	case ( KEY_PLUS | KEYBRD_HOLD ):									\
	  DSCONF_INCREMENT_PROPERTY(Config::get(), property);				\
	  Display::get()->number ( setup ## _setup_read_value ());			\
	  set_handled (ctx);												\
	  break;															\
  }


namespace ds
{
/*-----------------------------------------------------------------------*/
typedef void (*pfn_activate)(void);
typedef void (*pfn_exit)(void);
typedef void (*pfn_handler)(pmenu_context_t, keybrd_event_t);
typedef int (*pfn_read_value)(void);

typedef struct s_menu_desc menu_desc_t;

struct s_menu_desc {
  const char text[MENU_LABEL_LEN + 1];
  uint8_t fmt;
  pfn_activate activate;
  pfn_exit exit_fn;
  pfn_handler handler;
  pfn_read_value read_value;
  const menu_desc_t *sub_items;
  uint8_t sub_count;
};

/*-----------------------------------------------------------------------*\
 * Menu Handlers
\*-----------------------------------------------------------------------*/

static void ense_before_hints_setup (pmenu_context_t, keybrd_event_t);
static void ense_after_hints_setup (pmenu_context_t, keybrd_event_t);
static void ense_sleep_scenario_setup (pmenu_context_t, keybrd_event_t);
static void ense_recording_setup (pmenu_context_t, keybrd_event_t);
static void ense_record_gain_setup (pmenu_context_t, keybrd_event_t);
static void ense_volume_level_setup (pmenu_context_t, keybrd_event_t);
static void ense_tunes_setup (pmenu_context_t, keybrd_event_t);
static void ense_delete_records_setup (pmenu_context_t, keybrd_event_t);
static void ense_vibration_setup (pmenu_context_t, keybrd_event_t);
static void ense_speaker_setup (pmenu_context_t, keybrd_event_t);

static void ense_before_hints_setup_activate (void);
static void ense_after_hints_setup_activate (void);
static void ense_sleep_scenario_setup_activate (void);
static void ense_recording_setup_activate (void);
static void ense_record_gain_setup_activate (void);
static void ense_volume_level_setup_activate (void);
static void ense_tunes_setup_activate (void);
static void ense_vibration_setup_activate (void);
static void ense_speaker_setup_activate (void);
static void ense_delete_records_setup_activate (void);

static int ense_before_hints_setup_read_value (void);
static int ense_after_hints_setup_read_value (void);
static int ense_sleep_scenario_setup_read_value (void);
static int ense_recording_setup_read_value (void);
static int ense_record_gain_setup_read_value (void);
static int ense_volume_level_setup_read_value (void);
static int ense_tunes_setup_read_value (void);
static int ense_vibration_setup_read_value (void);
static int ense_speaker_setup_read_value (void);

static void remd_profile_setup (pmenu_context_t, keybrd_event_t);
static void remd_sensitivity_setup (pmenu_context_t, keybrd_event_t);
static void remd_required_rem_epochs_setup (pmenu_context_t, keybrd_event_t);
static void remd_cooldown_epochs_setup (pmenu_context_t, keybrd_event_t);
static void remd_min_move_duration_setup (pmenu_context_t, keybrd_event_t);
static void remd_min_epoch_moves_setup (pmenu_context_t, keybrd_event_t);
static void remd_restlessness_factor_setup (pmenu_context_t, keybrd_event_t);
static void remd_profile_setup_activate (void);
static void remd_sensitivity_setup_activate (void);
static void remd_required_rem_epochs_setup_activate (void);
static void remd_cooldown_epochs_setup_activate (void);
static void remd_min_move_duration_setup_activate (void);
static void remd_min_epoch_moves_setup_activate (void);
static void remd_restlessness_factor_setup_activate (void);
static void remd_sensitivity_setup_exit (void);
static void remd_required_rem_epochs_setup_exit (void);
static void remd_cooldown_epochs_setup_exit (void);
static void remd_min_move_duration_setup_exit (void);
static void remd_min_epoch_moves_setup_exit (void);
static void remd_restlessness_factor_setup_exit (void);
static int remd_profile_setup_read_value (void);
static int remd_sensitivity_setup_read_value (void);
static int remd_required_rem_epochs_setup_read_value (void);
static int remd_cooldown_epochs_setup_read_value (void);
static int remd_min_move_duration_setup_read_value (void);
static int remd_min_epoch_moves_setup_read_value (void);
static int remd_restlessness_factor_setup_read_value (void);

static int duplex_mode_setup_read_value (void);
static int wakeup_mode_setup_read_value (void);
static int alarm_clock_setup_read_value (void);
static int hints_frequency_setup_read_value (void);
static int hints_duty_cycle_setup_read_value (void);
static int light_hints_brightness_setup_read_value (void);
static int sound_hints_level_setup_read_value (void);
static int light_hints_duration_setup_read_value (void);
static int sound_hints_duration_setup_read_value (void);

static void clock_setup (pmenu_context_t, keybrd_event_t);
static void trigger_clocks_setup (pmenu_context_t, keybrd_event_t);
static void duplex_mode_setup (pmenu_context_t, keybrd_event_t);
static void wakeup_mode_setup (pmenu_context_t, keybrd_event_t);
static void alarm_clock_setup (pmenu_context_t, keybrd_event_t);
static void hints_frequency_setup (pmenu_context_t, keybrd_event_t);
static void hints_duty_cycle_setup (pmenu_context_t, keybrd_event_t);
static void light_hints_brightness_setup (pmenu_context_t, keybrd_event_t);
static void sound_hints_level_setup (pmenu_context_t, keybrd_event_t);
static void light_hints_duration_setup (pmenu_context_t, keybrd_event_t);
static void sound_hints_duration_setup (pmenu_context_t, keybrd_event_t);
static void wakeup_signal_check_handler (pmenu_context_t, keybrd_event_t);
static void remd_check_handler (pmenu_context_t, keybrd_event_t);
static void set_defaults_handler (pmenu_context_t, keybrd_event_t);
static void save_settings_handler (pmenu_context_t, keybrd_event_t);

static void clock_setup_activate (void);
static void wakeup_timer_setup_activate (void);
static void trigger_count_display (void);
static void trigger_clocks_setup_activate (void);
static void duplex_mode_setup_activate (void);
static void wakeup_mode_setup_activate (void);
static void alarm_clock_setup_activate (void);
static void hints_frequency_setup_activate (void);
static void hints_duty_cycle_setup_activate (void);
static void light_hints_brightness_setup_activate (void);
static void sound_hints_level_setup_activate (void);
static void light_hints_duration_setup_activate (void);
static void sound_hints_duration_setup_activate (void);
static void remd_check_activate (void);
static void set_defaults_activate (void);
static void save_settings_activate (void);

static void clock_setup_exit (void);
static void wakeup_timer_setup_exit (void);
static void trigger_clocks_setup_exit (void);
static void light_hints_duration_setup_exit (void);
static void sound_hints_duration_setup_exit (void);
static void remd_check_exit (void);

// REM Detector Settings
PROGMEM const menu_desc_t desc_rdse[] = {
  {
	"dP-%i\0\0",
	1,
	remd_profile_setup_activate,
	nullptr,
	remd_profile_setup,
	remd_profile_setup_read_value,
  },
  {
	// REM Detector Sensitivity 
	"SE-%i\0",
	1,
	remd_sensitivity_setup_activate,
	remd_sensitivity_setup_exit,
	remd_sensitivity_setup,
	remd_sensitivity_setup_read_value,
  },
  {
	// Min Required REM Epochs
	"Er-%i\0\0",
	1,
	remd_required_rem_epochs_setup_activate,
	remd_required_rem_epochs_setup_exit,
	remd_required_rem_epochs_setup,
	remd_required_rem_epochs_setup_read_value,
  },
  {
	// REM Detector Cooldown Epochs
	"C-%.2i\0",
	2,
	remd_cooldown_epochs_setup_activate,
	remd_cooldown_epochs_setup_exit,
	remd_cooldown_epochs_setup,
	remd_cooldown_epochs_setup_read_value,
  },
  {
	// Minimum Required Move Duration
	"d-%.2i\0",
	2,
	remd_min_move_duration_setup_activate,
	remd_min_move_duration_setup_exit,
	remd_min_move_duration_setup,
	remd_min_move_duration_setup_read_value,
  },
  {
	// Minimum Required Moves Per Epoch
	"t-%.2i\0",
	2,
	remd_min_epoch_moves_setup_activate,
	remd_min_epoch_moves_setup_exit,
	remd_min_epoch_moves_setup,
	remd_min_epoch_moves_setup_read_value,
  },
  {
	// Restlessness factor
	"r-%.2i\0",
	2,
	remd_restlessness_factor_setup_activate,
	remd_restlessness_factor_setup_exit,
	remd_restlessness_factor_setup,
	remd_restlessness_factor_setup_read_value,
  }
};

// Enhanced Settings
PROGMEM const menu_desc_t desc_ense[] = {
  {
	"bE-%i\0\0",
	1,
	ense_before_hints_setup_activate,
	nullptr,
	ense_before_hints_setup,
	ense_before_hints_setup_read_value,
  },
  {
	"AF-%i\0\0",
	1,
	ense_after_hints_setup_activate,
	nullptr,
	ense_after_hints_setup,
	ense_after_hints_setup_read_value,
  },
  {
	"Sc-%i\0\0",
	1,
	ense_sleep_scenario_setup_activate,
	nullptr,
	ense_sleep_scenario_setup,
	ense_sleep_scenario_setup_read_value,
  },
  {
	"rd-%i\0\0",
	1,
	ense_recording_setup_activate,
	nullptr,
	ense_recording_setup,
	ense_recording_setup_read_value,
  },
  {
	"rG-%i\0\0",
	1,
	ense_record_gain_setup_activate,
	nullptr,
	ense_record_gain_setup,
	ense_record_gain_setup_read_value,
  },
  {
	"LE-%i\0\0",
	1,
	ense_volume_level_setup_activate,
	nullptr,
	ense_volume_level_setup,
	ense_volume_level_setup_read_value,
  },
  {
	"tu-%i\0\0",
	1,
	ense_tunes_setup_activate,
	nullptr,
	ense_tunes_setup,
	ense_tunes_setup_read_value,
  },
  {
	"dELr\0\0\0",
	0,
	ense_delete_records_setup_activate,
	nullptr,
	ense_delete_records_setup,
  },
  {
	"FL-%i\0\0",
	1,
	ense_vibration_setup_activate,
	nullptr,
	ense_vibration_setup,
	ense_vibration_setup_read_value,
  },
  {
	"SP-%i\0\0",
	1,
	ense_speaker_setup_activate,
	nullptr,
	ense_speaker_setup,
	ense_speaker_setup_read_value,
  },
};


/*-----------------------------------------------------------------------*\
 * Menu Labels
\*-----------------------------------------------------------------------*/

PROGMEM const menu_desc_t desc_root[] = {
  {
	"CLSE\0\0\0",
	0,
	clock_setup_activate,
	clock_setup_exit,
	clock_setup,
  },
  {
	"UtSE\0\0\0",
	0,
	wakeup_timer_setup_activate,
	wakeup_timer_setup_exit,
	AppMenu::wakeup_timer_setup,
  },
  {
	"EnSE\0\0\0",
	0,
	nullptr,
	nullptr,
	nullptr,
	nullptr,
	desc_ense,
	sizeof(desc_ense)/sizeof(desc_ense[0]),
  },
  {
	"Cotr\0\0\0",
	0,
	trigger_count_display,
  },
  {
	"CLtr\0\0\0",
	0,
	trigger_clocks_setup_activate,
	trigger_clocks_setup_exit,
	trigger_clocks_setup,
  },
  {
	"rdSE\0\0\0",
	0,
	nullptr,
	nullptr,
	nullptr,
	nullptr,
	desc_rdse,
	sizeof(desc_rdse)/sizeof(desc_rdse[0]),
  },
  {
	"du-%i\0\0",
	1,
	duplex_mode_setup_activate,
	nullptr,
	duplex_mode_setup,
	duplex_mode_setup_read_value,
  },
  {
	"UP-%i\0\0",
	1,
	wakeup_mode_setup_activate,
	nullptr,
	wakeup_mode_setup,
	wakeup_mode_setup_read_value,
  },
  {
	"AL-%i\0\0",
	1,
	alarm_clock_setup_activate,
	nullptr,
	alarm_clock_setup,
	alarm_clock_setup_read_value,
  },
  {
	"Fr-%i\0\0",
	1,
	hints_frequency_setup_activate,
	nullptr,
	hints_frequency_setup,
	hints_frequency_setup_read_value,
  },
  {
	"Od-%i\0\0",
	1,
	hints_duty_cycle_setup_activate,
	nullptr,
	hints_duty_cycle_setup,
	hints_duty_cycle_setup_read_value
  },
  {
	"br-%i\0\0",
	1,
	light_hints_brightness_setup_activate,
	nullptr,
	light_hints_brightness_setup,
	light_hints_brightness_setup_read_value,
  },
  {
	"LE-%i\0\0",
	1,
	sound_hints_level_setup_activate,
	nullptr,
	sound_hints_level_setup,
	sound_hints_level_setup_read_value,
  },
  {
	"F-%.2i\0",
	2,
	light_hints_duration_setup_activate,
	light_hints_duration_setup_exit,
	light_hints_duration_setup,
	light_hints_duration_setup_read_value,
  },
  {
	"S-%.2i\0",
	2,
	sound_hints_duration_setup_activate,
	sound_hints_duration_setup_exit,
	sound_hints_duration_setup,
	sound_hints_duration_setup_read_value,
  },
  {
	// check installed wakeup signals
	"ChUS\0\0\0",
	0,
	nullptr,
	nullptr,
	wakeup_signal_check_handler,
  },
  {
	// check REM detector 
	"Chdt\0\0\0",
	0,
	remd_check_activate,
	remd_check_exit,
	remd_check_handler,
  },
  {
	// Reset configuration to defaults
	"rSEt\0\0\0",
	0,
	set_defaults_activate,
	nullptr,
	set_defaults_handler,
  },
  {
	// Save configuration to EEPROM 
	"SAUE\0\0\0",
	0,
	save_settings_activate,
	nullptr,
	save_settings_handler,
  },
};


static 
void set_unhandled (menu_context_t *ctx)
{
  ctx->res = MENU_UNHANDLED;
}

static
void set_handled (menu_context_t *ctx)
{
  ctx->res |= MENU_HANDLED;
}

static
void set_return (menu_context_t *ctx)
{
  ctx->res |= MENU_RETURN;
}

static
uint8_t set_menu_exit (menu_context_t *ctx)
{
  ctx->level = MENU_INVALID_LEVEL;
  ctx->res	= (MENU_HANDLED | MENU_EXIT);

  return ctx->res;
}

bool plane_is_active (menu_context_t *ctx)
{
  return ctx->plane [ctx->level].is_active != 0;
}

void plane_activate (menu_context_t *ctx, bool activate)
{
  ctx->plane [ctx->level].is_active = (activate ? 1 : 0);
}


/* ----------------------------------------------------------------------*\
 * Menu layout accessors
\*-----------------------------------------------------------------------*/

static
const char *desc_text(const uint8_t *desc_addr, char *buf)
{
  strcpy_P(buf, (const char *)(desc_addr + offsetof(menu_desc_t, text)));
  return buf;
}

static
uint8_t desc_fmt(const uint8_t *desc_addr)
{
  return pgm_read_byte_far(desc_addr + offsetof(menu_desc_t, fmt));
}

static
pfn_activate desc_activate_func(const uint8_t *desc_addr)
{
  return (pfn_activate) pgm_read_ptr_far(desc_addr 
									+ offsetof(menu_desc_t, activate));
}

static
pfn_exit desc_exit_func(const uint8_t *desc_addr)
{
  return (pfn_exit) pgm_read_ptr_far(desc_addr
									+ offsetof(menu_desc_t, exit_fn));
}

static
pfn_handler desc_handler_func(const uint8_t *desc_addr)
{
  return (pfn_handler) pgm_read_ptr_far(desc_addr
									+ offsetof(menu_desc_t, handler));
}

static
pfn_read_value desc_read_value_func(const uint8_t *desc_addr)
{
  return (pfn_read_value) pgm_read_ptr_far(desc_addr
									+ offsetof(menu_desc_t, read_value));
}

static
const uint8_t *desc_sub_items(const uint8_t *desc_addr)
{
  return (const uint8_t *) pgm_read_ptr_far(desc_addr
									+ offsetof(menu_desc_t, sub_items));
}

static
uint8_t desc_sub_count(const uint8_t *desc_addr)
{
  return pgm_read_byte_far(desc_addr + offsetof(menu_desc_t, sub_count));
}

const uint8_t *desc_addr (pmenu_context_t ctx, int level)
{
  const uint8_t *addr = (const uint8_t *)&desc_root;
  int8_t l = 0;
  do {
	addr = addr + sizeof(menu_desc_t) * ctx->plane[l].index;
	if (l< level)
	  addr = desc_sub_items(addr);
  } while (level>l++);

  return addr;
}

const uint8_t *get_addr (pmenu_context_t ctx)
{
  return desc_addr (ctx, ctx->level);
}

const char *get_text(pmenu_context_t ctx, char *buf)
{
  return desc_text (get_addr (ctx), buf);
}

uint8_t get_fmt (pmenu_context_t ctx)
{
  return desc_fmt (get_addr (ctx));
}

uint8_t get_sub_count (pmenu_context_t ctx)
{
  return desc_sub_count (get_addr (ctx));
}

static
pfn_activate get_activate_func(pmenu_context_t ctx)
{
  return desc_activate_func (get_addr (ctx));
}

static
pfn_exit get_exit_func (pmenu_context_t ctx)
{
  return desc_exit_func (get_addr (ctx));
}

static
pfn_handler get_handler_func(pmenu_context_t ctx)
{
  return desc_handler_func (get_addr (ctx));
}

static
pfn_read_value get_read_value_func (pmenu_context_t ctx)
{
  return desc_read_value_func (get_addr (ctx));
}


/*-----------------------------------------------------------------------*\
 * Menu navigation
\*-----------------------------------------------------------------------*/

void plane_next (pmenu_context_t ctx)
{
  menu_plane_t *plane;
  uint8_t count;

  count = get_sub_count(ctx);
  plane = &ctx->plane [++ctx->level];

  plane->index = 0;
  plane->count = count;
}

int plane_prev (pmenu_context_t ctx)
{
  if (ctx->level == 0)	/*Can't move prev anymore*/
	return MENU_INVALID_LEVEL;

  return --ctx->level;
}

void index_next (pmenu_context_t ctx)
{
  menu_plane_t *plane;

  plane = &ctx->plane [ctx->level];

  plane->index = (plane->index + 1) % plane->count;
}

/*-----------------------------------------------------------------------*\
 * Menu Functions
\*-----------------------------------------------------------------------*/

void update_menu (pmenu_context_t ctx)
{
  char temp[10];
  char buf[5];
  const char *msg;
  pfn_read_value read_val;

  if (get_fmt (ctx) > 0) {
	read_val = get_read_value_func (ctx);

	snprintf(buf, 5, get_text(ctx, temp), (read_val ? read_val () : 0));
	msg = buf;
  }
  else
	msg = get_text (ctx, temp);

  Display::get()->message (msg, 1);
}

/*-----------------------------------------------------------------------*/
AppMenu menu;

/*-----------------------------------------------------------------------*/
AppMenu *AppMenu::get()
{
  return &menu;
}

/*-----------------------------------------------------------------------*/
bool AppMenu::init (void)
{
  memset (&ctx, 0, sizeof(ctx));

  ctx.level = MENU_INVALID_LEVEL;
  ctx.plane[0].count = sizeof (desc_root) / sizeof (desc_root[0]);
  return true;
}

void AppMenu::enter (void)
{
  ctx.level = 0;
  ctx.plane[0].index = 0;

  update_menu (&ctx);
}

bool AppMenu::is_active (void)
{
  return (ctx.level > MENU_INVALID_LEVEL);
}

void AppMenu::play_tone (void)
{
  Tonegen::get()->beep ( 80, 4, 6, Config::get()->get_volume_level ());
}

int AppMenu::handle_key (uint8_t key_event)
{
  pfn_activate activate_fn;
  pfn_exit exit_fn;
  pfn_handler handler_fn;

  if (! is_active ())
	return MENU_UNHANDLED;

  set_unhandled(&ctx);

  if (key_event == (KEY_SELECT | KEYBRD_HOLD)) {
	play_tone ();

	if (plane_is_active (&ctx)) {
	  // if at submenu level
	  exit_fn = get_exit_func (&ctx);
	  if (exit_fn)
		exit_fn();
	}
	if (plane_prev (&ctx) < 0)
	  return set_menu_exit (&ctx);
	update_menu (&ctx);
	set_handled (&ctx);
	return MENU_HANDLED;
  }

  if (! plane_is_active (&ctx)) {
	switch (key_event) {
	  case KEY_SELECT:
	  	play_tone ();
		// move to the next menu item
		index_next (&ctx);
		update_menu (&ctx);
		set_handled (&ctx);
		break;

	  case KEY_ENTER:
	  	play_tone ();
		// enter the submenu
		if (get_sub_count (&ctx) > 0) {
			plane_next (&ctx);
			update_menu (&ctx);
		} else {
			activate_fn = get_activate_func (&ctx);
			if (activate_fn)
				activate_fn ();
			plane_activate (&ctx, true);
		}
		set_handled(&ctx);
		break;
	}

  } else {
	// if an item is activated
	play_tone ();
	switch (key_event) {
	  case KEY_SELECT:
		exit_fn = desc_exit_func (get_addr (&ctx));
		if (exit_fn)
		  exit_fn();
		// deactivate the item
		plane_activate (&ctx, false);
		update_menu (&ctx);
		set_handled (&ctx);
		break;

	  default:
		/* forward event to submenu handler */
		handler_fn = get_handler_func (&ctx);
		if (handler_fn) {
		  handler_fn(&ctx, key_event);
		  /* check if return from item */
		  if (ctx.res & MENU_RETURN) {
			plane_activate (&ctx, false);
			update_menu (&ctx);
		  }
		}
		break;
	}
  }

  return ctx.res;
}

/*-----------------------------------------------------------------------*\
 * Menu Handlers (implementation)
\*-----------------------------------------------------------------------*/

void ense_before_hints_setup_activate (void)
{
  Display::get()->flag (ense_before_hints_setup_read_value ());
}

void ense_before_hints_setup ( pmenu_context_t ctx, keybrd_event_t key_event)
{
  switch ( key_event ) {
	case ( KEY_MINUS ):
	case ( KEY_PLUS ):
	  Config::get()->toggle_before_hints ();

	  Display::get()->flag (ense_before_hints_setup_read_value ());
	  set_handled (ctx);
	  break;
  }
}

int ense_before_hints_setup_read_value (void)
{
  return Config::get()->get_before_hints();
}

void ense_after_hints_setup_activate (void)
{
  Display::get()->flag (ense_after_hints_setup_read_value ());
}

void ense_after_hints_setup ( pmenu_context_t ctx, keybrd_event_t key_event)
{
  switch ( key_event ) {
	case ( KEY_MINUS ):
	case ( KEY_PLUS ):
	  Config::get()->toggle_after_hints ();

	  Display::get()->flag ( ense_after_hints_setup_read_value ());
	  set_handled (ctx);
	  break;
  }
}

int ense_after_hints_setup_read_value (void)
{
  return Config::get()->get_after_hints ();
}

static
void disp_sleep_scenario (void)
{
  Display::get()->number (ense_sleep_scenario_setup_read_value ());
}

void ense_sleep_scenario_setup_activate (void)
{
  disp_sleep_scenario ();
}

void ense_sleep_scenario_setup ( pmenu_context_t ctx, keybrd_event_t key_event)
{
  switch ( key_event ) {
	case ( KEY_ENTER ):
	  // TODO: playback
	  set_handled (ctx);
	  break;

	case ( KEY_MINUS ):
	case ( KEY_MINUS | KEYBRD_HOLD ):
	  DSCONF_DECREMENT_PROPERTY(Config::get(), sleep_scenario);

	  disp_sleep_scenario ();
	  set_handled (ctx);
	  break;

	case ( KEY_PLUS ):
	case ( KEY_PLUS | KEYBRD_HOLD ):
	  DSCONF_INCREMENT_PROPERTY(Config::get(), sleep_scenario);

	  disp_sleep_scenario ();
	  set_handled (ctx);
	  break;
  }
}

int ense_sleep_scenario_setup_read_value (void)
{
  return Config::get()->get_sleep_scenario();
}

void ense_recording_setup_activate ( void )
{
  Display::get()->flag (ense_recording_setup_read_value () );
}

void ense_recording_setup ( pmenu_context_t ctx, keybrd_event_t key_event )
{
  String newfile;
  auto *codec = AudioCodec::get();

  switch ( key_event ) {
	case ( KEY_ENTER ):
	  if (codec->get_state() == AudioCodec::State::Playback) {
		codec->stop();
	  }

	  if (codec->get_state() == AudioCodec::State::None) {
		// TODO: playback next recording
	  }
	  set_handled (ctx);
	  break;

	case ( KEY_CHECK ):
	  if (codec->get_state() == AudioCodec::State::Capture) {
		codec->stop ();
	  }
	  else if (codec->get_state() == AudioCodec::State::None) {
		// Start new recording 
		Files::make_next_file_path(newfile, RECORDS_PATH, "REC", "WAV", 5);
		codec->capture (newfile.c_str());
	  }
	  else {
		/* TODO: is a real case ? playing music ? */
	  }
	  set_handled (ctx);
	  break;

	case ( KEY_MINUS ):
	case ( KEY_PLUS ):
	  Config::get()->toggle_voice_recording ();

	  Display::get()->flag (ense_recording_setup_read_value ());
	  set_handled (ctx);
	  break;
  }
}

int ense_recording_setup_read_value (void)
{
  return Config::get()->get_voice_recording ();
}

void ense_record_gain_setup_activate (void)
{
  Display::get()->number ( ense_record_gain_setup_read_value ());
}

void ense_record_gain_setup (pmenu_context_t ctx, keybrd_event_t key_event)
{
  MENU_NUMERIC_PROPERTY_SETUP(ense_record_gain, record_gain_level, ctx, key_event)
}

int ense_record_gain_setup_read_value (void)
{
  return Config::get()->get_record_gain_level ();
}

void ense_volume_level_setup_activate (void)
{
  Display::get()->number ( ense_volume_level_setup_read_value ());
}

void ense_volume_level_setup (pmenu_context_t ctx, keybrd_event_t key_event)
{
  MENU_NUMERIC_PROPERTY_SETUP(ense_volume_level, volume_level, ctx, key_event)
}

int ense_volume_level_setup_read_value (void)
{
  return Config::get()->get_volume_level ();
}

static
void disp_relax_tunes (void)
{
  Display::get()->number (ense_tunes_setup_read_value ());
}

void ense_tunes_setup_activate (void)
{
  disp_relax_tunes ();
}

void ense_tunes_setup ( pmenu_context_t ctx, keybrd_event_t key_event )
{
  switch ( key_event ) {
	case ( KEY_ENTER ):
	  // TODO: playback
	  set_handled (ctx);
	  break;

	case ( KEY_MINUS ):
	case ( KEY_MINUS | KEYBRD_HOLD ):
	  DSCONF_DECREMENT_PROPERTY(Config::get(), relax_tunes);

	  disp_relax_tunes ();
	  set_handled (ctx);
	  break;

	case ( KEY_PLUS ):
	case ( KEY_PLUS | KEYBRD_HOLD ):
	  DSCONF_INCREMENT_PROPERTY(Config::get(), relax_tunes);

	  disp_relax_tunes ();
	  set_handled (ctx);
	  break;
  }
}

int ense_tunes_setup_read_value (void)
{
  return Config::get()->get_relax_tunes ();
}

void ense_delete_records_setup ( pmenu_context_t ctx, keybrd_event_t key_event)
{
  switch( key_event )	{
	case ( KEY_ENTER ):
	  // TODO: delete records
	  Display::get()->message (__disp_msg_done__, 300);
	  set_handled (ctx);
	  set_return (ctx);
	  break;
  }
}

void ense_delete_records_setup_activate (void)
{
  Display::get()->confirm ();
}

void ense_vibration_setup_activate (void)
{
  Display::get()->number (ense_vibration_setup_read_value ());
}

void ense_vibration_setup ( pmenu_context_t ctx, keybrd_event_t key_event)
{
  switch( key_event ) {
	case ( KEY_ENTER ):
	  if (ense_vibration_setup_read_value ()) {
		VibroMotor::get()->start (ense_vibration_setup_read_value (), 2000);
	  }
	  set_handled (ctx);
	  break;

	case ( KEY_MINUS ):
	case ( KEY_MINUS | KEYBRD_HOLD ):
	  DSCONF_DECREMENT_PROPERTY(Config::get(), vibration_level);

	  Display::get()->number (ense_vibration_setup_read_value ());
	  set_handled (ctx);
	  break;

	case ( KEY_PLUS ):
	case ( KEY_PLUS | KEYBRD_HOLD ):
	  DSCONF_INCREMENT_PROPERTY(Config::get(), vibration_level);

	  Display::get()->number (ense_vibration_setup_read_value ());
	  set_handled (ctx);
	  break;
  }
}

int ense_vibration_setup_read_value (void)
{
  return Config::get()->get_vibration_level ();
}

void ense_speaker_setup_activate ( void )
{
  Display::get()->flag (ense_speaker_setup_read_value () );
}

void ense_speaker_setup ( pmenu_context_t ctx, keybrd_event_t key_event )
{
  switch ( key_event ) {
	case ( KEY_MINUS ):
	case ( KEY_PLUS ):
	  if (ense_speaker_setup_read_value ()) {
		Sound::get()->speaker_on ();
	  }
	  else {
		Sound::get()->speaker_off ();
	  }

	  Config::get()->toggle_loud_speaker_enabled ();
	  Display::get()->flag (ense_speaker_setup_read_value ());

	  set_handled (ctx);
	  break;
  }
}

int ense_speaker_setup_read_value (void)
{
  return Config::get()->get_loud_speaker_enabled ();
}

void clock_setup_activate (void)
{
  auto clk = RTClock::get();

  // setup real-time clock
  clk->set_setup ( RTClock::SetupMode::Hour );
  clk->show ();

  Keyboard::get()->hold_repeat_default ();
}

void clock_setup_exit (void)
{
  auto clk = RTClock::get();

  Keyboard::get()->hold_repeat_disable ();

  // exit from setup
  clk->set_setup ( RTClock::SetupMode::None );
  clk->hide ();

  clk->backup_current_time ();
}

void clock_setup ( pmenu_context_t ctx, keybrd_event_t key_event )
{
  auto clk = RTClock::get();

  switch ( key_event ) {
	case ( KEY_ENTER ):
	  // switch between settings
	  clk->next_setup ();
	  set_handled (ctx);
	  break;

	case ( KEY_MINUS ):
	case ( KEY_MINUS | KEYBRD_HOLD ):
	  clk->setup_inc ( -1 );
	  set_handled (ctx);
	  break;

	case ( KEY_PLUS ):
	case ( KEY_PLUS | KEYBRD_HOLD ):
	  clk->setup_inc ( 1 );
	  set_handled (ctx);
	  break;
  }
}

void disp_wakeup_timer_delay (void)
{
  uint16_t delay = Config::get()->get_wakeup_timer_delay ();
  uint8_t hour = delay / 60;
  uint8_t minute = delay - ( 60U * hour );

  char msg[ 6 ];
  snprintf ( msg, 6, __disp_msg_time__, hour, minute );

  Display::get()->message (msg, 1);
}

// How much time is left before the timer goes off
void disp_wakeup_timer_remainder (void)
{
  uint16_t remainder;
  uint8_t hour, minute;
  char msg[ 6 ];

  remainder = RTClock::get()->wakeup_timer_get_remainder ();
  hour = remainder / 60;
  minute = remainder - ( 60U * hour );
  snprintf (msg, 6, __disp_msg_time__, hour, minute);

  Display::get()->message (msg, 1);
}

void wakeup_timer_setup_activate (void)
{
  disp_wakeup_timer_delay ();

  Keyboard::get()->hold_repeat_fast ();
}

void wakeup_timer_setup_exit (void)
{
  Keyboard::get()->hold_repeat_disable ();
}

void AppMenu::wakeup_timer_setup (pmenu_context_t ctx, keybrd_event_t key_event)
{
  bool is_set = RTClock::get()->wakeup_timer_is_set ();

  switch ( key_event ) {
	case ( KEY_ENTER ):
	  Driver::get()->wakeup_timer_toggle ();

	  disp_wakeup_timer_delay ();
	  set_handled (ctx);
	  break;

	case ( KEY_MINUS ):
	case ( KEY_MINUS | KEYBRD_HOLD ):
	  if (! is_set ) {

	  	DSCONF_DECREMENT_PROPERTY(Config::get(), wakeup_timer_delay );
	  	disp_wakeup_timer_delay ();
	  }

	  set_handled (ctx);
	  break;

	case ( KEY_PLUS ):
	case ( KEY_PLUS | KEYBRD_HOLD ):
	  if (! is_set ) {

	  	DSCONF_INCREMENT_PROPERTY(Config::get(), wakeup_timer_delay );
	  	disp_wakeup_timer_delay ();
	  }

	  set_handled (ctx);
	  break;

	case ( KEY_CHECK ):
	  if ( is_set ) {
		/* Remainder is only valid if timer is active
		 */
	  	disp_wakeup_timer_remainder ();
	  }
	  set_handled (ctx);
	  break;
  }
}

void trigger_count_display (void)
{
  Display::get()->number (Config::get()->get_remd_trigger_count ());
}

// TODO: implement reading triggering history
void trigger_clocks_setup_activate (void)
{
  Keyboard::get()->hold_repeat_fast ();
}

void trigger_clocks_setup_exit (void)
{
  Keyboard::get()->hold_repeat_disable ();
}

void trigger_clocks_setup ( pmenu_context_t, keybrd_event_t key_event )
{
  switch ( key_event ) {
	case ( KEY_MINUS ):
	case ( KEY_MINUS | KEYBRD_HOLD ):
		break;

	case ( KEY_PLUS ):
	case ( KEY_PLUS | KEYBRD_HOLD ):
		break;
  }
}

static
void disp_remd_profile (void)
{
  if ( Config::get()->is_remd_profile_invalid ()) {

	Display::get()->message ( __disp_msg_off__, 1 );
  } else {

	Display::get()->number (remd_profile_setup_read_value ());
  }
}

void remd_profile_setup_activate (void)
{
  disp_remd_profile ();
}

void remd_profile_setup (pmenu_context_t ctx, keybrd_event_t key_event)
{
  switch ( key_event ) {
	case ( KEY_ENTER ):
	  DSCONF_TOGGLE_PROPERTY_WITH_INVALID(Config::get(), remd_profile);

	  disp_remd_profile ();
	  set_handled (ctx);
	  break;

	case ( KEY_MINUS ):
	  DSCONF_DECREMENT_PROPERTY(Config::get(), remd_profile);

	  disp_remd_profile ();
	  set_handled (ctx);
	  break;

	case ( KEY_PLUS ):
	  DSCONF_INCREMENT_PROPERTY(Config::get(), remd_profile);

	  disp_remd_profile ();
	  set_handled (ctx);
	  break;
  }
}

void remd_sensitivity_setup_activate (void)
{
  Display::get()->number (remd_sensitivity_setup_read_value ());

  Keyboard::get()->hold_repeat_fast ();
}

void remd_sensitivity_setup_exit (void)
{
  Keyboard::get()->hold_repeat_disable ();
}

void remd_sensitivity_setup (pmenu_context_t ctx, keybrd_event_t key_event)
{
  MENU_NUMERIC_PROPERTY_SETUP(remd_sensitivity, remd_sensitivity, ctx, key_event)
}

void remd_required_rem_epochs_setup_activate (void)
{
  Display::get()->number (remd_required_rem_epochs_setup_read_value ());

  Keyboard::get()->hold_repeat_fast ();
}

void remd_required_rem_epochs_setup_exit (void)
{
  Keyboard::get()->hold_repeat_disable ();
}

void remd_required_rem_epochs_setup (pmenu_context_t ctx, keybrd_event_t key_event)
{
  MENU_NUMERIC_PROPERTY_SETUP(remd_required_rem_epochs, remd_required_rem_epochs, ctx, key_event)
}

void remd_cooldown_epochs_setup_activate (void)
{
  Display::get()->number (remd_cooldown_epochs_setup_read_value ());

  Keyboard::get()->hold_repeat_fast ();
}

void remd_cooldown_epochs_setup_exit (void)
{
  Keyboard::get()->hold_repeat_disable ();
}

void remd_cooldown_epochs_setup (pmenu_context_t ctx, keybrd_event_t key_event)
{
  MENU_NUMERIC_PROPERTY_SETUP(remd_cooldown_epochs, remd_cooldown_epochs, ctx, key_event)
}

void remd_min_move_duration_setup_activate (void)
{
  Display::get()->number (remd_min_move_duration_setup_read_value ());

  Keyboard::get()->hold_repeat_fast ();
}

void remd_min_move_duration_setup_exit (void)
{
  Keyboard::get()->hold_repeat_disable ();
}

void remd_min_move_duration_setup (pmenu_context_t ctx, keybrd_event_t key_event)
{
  MENU_NUMERIC_PROPERTY_SETUP(remd_min_move_duration, remd_min_move_duration, ctx, key_event)
}

void remd_min_epoch_moves_setup_activate (void)
{
  Display::get()->number (remd_min_epoch_moves_setup_read_value ());

  Keyboard::get()->hold_repeat_fast ();
}

void remd_min_epoch_moves_setup_exit (void)
{
  Keyboard::get()->hold_repeat_disable ();
}

void remd_min_epoch_moves_setup (pmenu_context_t ctx, keybrd_event_t key_event)
{
  MENU_NUMERIC_PROPERTY_SETUP(remd_min_epoch_moves, remd_min_epoch_moves, ctx, key_event)
}

void remd_restlessness_factor_setup_activate (void)
{
  Display::get()->number (remd_restlessness_factor_setup_read_value ());

  Keyboard::get()->hold_repeat_fast ();
}

void remd_restlessness_factor_setup_exit (void)
{
  Keyboard::get()->hold_repeat_disable ();
}

void remd_restlessness_factor_setup (pmenu_context_t ctx, keybrd_event_t key_event)
{
  MENU_NUMERIC_PROPERTY_SETUP(remd_restlessness_factor, remd_restlessness_factor, ctx, key_event)
}

int remd_profile_setup_read_value (void)
{
	return Config::get()->get_remd_profile ();
}

int remd_sensitivity_setup_read_value (void)
{
  return Config::get()->get_remd_sensitivity ();
}

int remd_required_rem_epochs_setup_read_value (void)
{
  return Config::get()->get_remd_required_rem_epochs ();
}

int remd_cooldown_epochs_setup_read_value (void)
{
  return Config::get()->get_remd_cooldown_epochs ();
}

int remd_min_move_duration_setup_read_value (void)
{
  return Config::get()->get_remd_min_move_duration ();
}

int remd_min_epoch_moves_setup_read_value (void)
{
  return Config::get()->get_remd_min_epoch_moves ();
}

int remd_restlessness_factor_setup_read_value (void)
{
  return Config::get()->get_remd_restlessness_factor ();
}

static
void disp_duplex_mode (void)
{
  if ( Config::get()->is_duplex_mode_invalid ())
	Display::get()->message ( __disp_msg_off__, 1 );
  else
	Display::get()->number (duplex_mode_setup_read_value ());
}

void duplex_mode_setup_activate (void)
{
	disp_duplex_mode ();
}

void duplex_mode_setup ( pmenu_context_t ctx, keybrd_event_t key_event )
{
  switch ( key_event ) {
	case ( KEY_ENTER ):
	  DSCONF_TOGGLE_PROPERTY_WITH_INVALID(Config::get(), duplex_mode);

	  disp_duplex_mode ();
	  set_handled (ctx);
	  break;

	case ( KEY_MINUS ):
	  DSCONF_DECREMENT_PROPERTY_WITH_INVALID(Config::get(), duplex_mode);

	  disp_duplex_mode ();
	  set_handled (ctx);
	  break;

	case ( KEY_PLUS ):
	  DSCONF_INCREMENT_PROPERTY_WITH_INVALID(Config::get(), duplex_mode);

	  disp_duplex_mode ();
	  set_handled (ctx);
	  break;
  }
}

int duplex_mode_setup_read_value (void)
{
  return Config::get()->get_duplex_mode ();
}

static
void disp_wakeup_mode (void)
{
  if ( Config::get()->is_wakeup_mode_invalid ()) {

	Display::get()->message ( __disp_msg_off__, 1 );
  } else {

	Display::get()->number (wakeup_mode_setup_read_value ());
  }
}

void wakeup_mode_setup_activate ( void )
{
	disp_wakeup_mode ();
}

void wakeup_mode_setup ( pmenu_context_t ctx, keybrd_event_t key_event )
{
  switch ( key_event ) {
	case ( KEY_ENTER ):
	  DSCONF_TOGGLE_PROPERTY_WITH_INVALID(Config::get(), wakeup_mode);

	  disp_wakeup_mode ();
	  set_handled (ctx);
	  break;

	case ( KEY_MINUS ):
	  DSCONF_DECREMENT_PROPERTY(Config::get(), wakeup_mode);

	  disp_wakeup_mode ();
	  set_handled (ctx);
	  break;

	case ( KEY_PLUS ):
	  DSCONF_INCREMENT_PROPERTY(Config::get(), wakeup_mode);

	  disp_wakeup_mode ();
	  set_handled (ctx);
	  break;
  }
}

int wakeup_mode_setup_read_value (void)
{
  return Config::get()->get_wakeup_mode ();
}

void alarm_clock_setup_activate (void)
{
  Display::get()->flag (alarm_clock_setup_read_value ());
}

void alarm_clock_setup ( pmenu_context_t ctx, keybrd_event_t key_event )
{
  switch ( key_event ) {
	case ( KEY_MINUS ):
	case ( KEY_PLUS ):
	  Config::get()->toggle_alarm_clock_enabled ();

	  Display::get()->flag (alarm_clock_setup_read_value ());
	  set_handled (ctx);
	  break;
  }
}

int alarm_clock_setup_read_value (void)
{
  return Config::get()->get_alarm_clock_enabled ();	
}

void hints_frequency_setup_activate (void)
{
  Display::get()->number (hints_frequency_setup_read_value ());
}

void hints_frequency_setup ( pmenu_context_t ctx, keybrd_event_t key_event)
{
  switch ( key_event ) {
	case ( KEY_MINUS ):
	  DSCONF_DECREMENT_PROPERTY(Config::get(), hints_frequency );

	  Display::get()->number (hints_frequency_setup_read_value ());
	  set_handled ( ctx );
	  break;

	case ( KEY_PLUS ):
	  DSCONF_INCREMENT_PROPERTY(Config::get(), hints_frequency );

	  Display::get()->number (hints_frequency_setup_read_value ());
	  set_handled ( ctx );
	  break;
  }
}

int hints_frequency_setup_read_value (void)
{
  return Config::get()->get_hints_frequency ();
}

void hints_duty_cycle_setup_activate (void)
{
  Display::get()->number (hints_duty_cycle_setup_read_value ());
}

void hints_duty_cycle_setup ( pmenu_context_t ctx, keybrd_event_t key_event)
{
  switch ( key_event ) {
	case ( KEY_MINUS ):
	  DSCONF_DECREMENT_PROPERTY(Config::get(), hints_duty_cycle );

	  Display::get()->number (hints_duty_cycle_setup_read_value ());
	  set_handled ( ctx );
	  break;

	case ( KEY_PLUS ):
	  DSCONF_INCREMENT_PROPERTY(Config::get(), hints_duty_cycle );

	  Display::get()->number (hints_duty_cycle_setup_read_value ());
	  set_handled ( ctx );
	  break;
  }
}

int hints_duty_cycle_setup_read_value (void)
{
  return Config::get()->get_hints_duty_cycle ();
}

void sound_hints_level_setup_activate ( void )
{
  Display::get()->number (sound_hints_level_setup_read_value () );
}

void sound_hints_level_setup ( pmenu_context_t ctx, keybrd_event_t key_event)
{
  switch ( key_event ) {
	case ( KEY_MINUS ):
	  DSCONF_DECREMENT_PROPERTY(Config::get(), sound_hints_volume );

	  Display::get()->number (sound_hints_level_setup_read_value () );
	  set_handled ( ctx );
	  break;

	case ( KEY_PLUS ):
	  DSCONF_INCREMENT_PROPERTY(Config::get(), sound_hints_volume );

	  Display::get()->number (sound_hints_level_setup_read_value ());
	  set_handled ( ctx );
	  break;
  }
}

int sound_hints_level_setup_read_value (void)
{
  return Config::get()->get_sound_hints_volume ();
}

void light_hints_brightness_setup_activate (void)
{
  Display::get()->number (light_hints_brightness_setup_read_value ());
}

void light_hints_brightness_setup ( pmenu_context_t ctx, keybrd_event_t key_event)
{
  switch ( key_event ) {
	case ( KEY_MINUS ):
	  DSCONF_DECREMENT_PROPERTY(Config::get(), light_hints_brightness );

	  Display::get()->number (light_hints_brightness_setup_read_value ());
	  set_handled ( ctx );
	  break;

	case ( KEY_PLUS ):
	  DSCONF_INCREMENT_PROPERTY(Config::get(), light_hints_brightness );

	  Display::get()->number (light_hints_brightness_setup_read_value ());
	  set_handled ( ctx );
	  break;
  }
}

int light_hints_brightness_setup_read_value (void)
{
  return Config::get()->get_light_hints_brightness ();
}

void light_hints_duration_setup_activate (void)
{
  Display::get()->number (light_hints_duration_setup_read_value ());

  Keyboard::get()->hold_repeat_fast ();
}

void light_hints_duration_setup_exit (void)
{
  Keyboard::get()->hold_repeat_disable ();
}

void light_hints_duration_setup (pmenu_context_t ctx, keybrd_event_t key_event)
{
  MENU_NUMERIC_PROPERTY_SETUP(light_hints_duration, light_hints_duration, ctx, key_event)
}

int light_hints_duration_setup_read_value (void)
{
  return Config::get()->get_light_hints_duration ();
}

void sound_hints_duration_setup_activate (void)
{
  Display::get()->number (sound_hints_duration_setup_read_value ());

  Keyboard::get()->hold_repeat_fast ();
}

void sound_hints_duration_setup_exit (void)
{
  Keyboard::get()->hold_repeat_disable ();
}

void sound_hints_duration_setup ( pmenu_context_t ctx, keybrd_event_t key_event)
{
  MENU_NUMERIC_PROPERTY_SETUP(sound_hints_duration, sound_hints_duration, ctx, key_event)
}

int sound_hints_duration_setup_read_value (void)
{
  return Config::get()->get_sound_hints_duration ();
}

void wakeup_signal_check_handler ( pmenu_context_t, keybrd_event_t key_event )
{
}

void remd_check_activate (void)
{
  // Enter REM detector check mode
  Driver::get()->remd_start_check ();
}

void remd_check_exit (void)
{
  // Exit REM detector check mode
  Driver::get()->remd_stop_check ();
}

void remd_check_handler ( pmenu_context_t, keybrd_event_t key_event)
{
}

void set_defaults_activate (void)
{
}

void set_defaults_handler ( pmenu_context_t, keybrd_event_t key_event)
{
  switch ( key_event ) {
	case ( KEY_ENTER ):
	  Config::get()->set_defaults ();
	  /* NOTE: device will restart */
	  break;
  }
}

void save_settings_handler ( pmenu_context_t ctx, keybrd_event_t key_event)
{
  switch ( key_event ) {
	case ( KEY_ENTER ):
	  Config::get()->save_to_storage ();
	  Display::get()->message (__disp_msg_done__, 300);
	  set_handled (ctx);
	  set_return (ctx);
	  break;
  }
}

void save_settings_activate (void)
{
  Display::get()->confirm ();
}

/*-----------------------------------------------------------------------*/
} //namespace ds
