orpaltech/dreamstalker/firmware/avrdreamstalkerpro/include/core/tmr_avr.h

/*
 * This file is part of the AVR Dreamstalker software
 * (https://github.com/orpaltech/dreamstalker).
 *
 * Copyright (c) 2013-2025	ORPAL Technologies, Inc.
 *
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
 * You should have received a copy of the GNU General Public License
 * along with this program. If not, see <http://www.gnu.org/licenses/>.
 */

#ifndef _TIMERS_AVR_DEFINED
#define _TIMERS_AVR_DEFINED



/* ------------------------------------------------------------------------- */
/* TIMER 1																	 */
/* ------------------------------------------------------------------------- */

// Clock Select Bit Description (page 136/157)
//----------------------------------------
//	CS12	CS11	CS10	Meaning
//----------------------------------------
//	0		0		0		No clock source / timer is off
//	0		0		1		No prescaling, F_CPU
//	0		1		0		F_CPU/8
//	0		1		1		F_CPU/64
//	1		0		0		F_CPU/256
//	1		0		1		F_CPU/1024
//

#define	T1_N_0      0
#define	T1_N_1		_BV(CS10)
#define	T1_N_8		_BV(CS11)
#define	T1_N_64		(_BV(CS11) | _BV(CS10))
#define	T1_N_256	_BV(CS12)
#define	T1_N_1024	(_BV(CS12) | _BV(CS10))

#define TMR1_SET_N(N)	TCCR1B = ((TCCR1B & ~(_BV(CS12)|_BV(CS11)|_BV(CS10))) | T1_N_ ## N )
#define TMR1_OFF()      TMR1_SET_N(0)

#if defined (__AVR_ATmega128__)

/* ------------------------------------------------------------------------- */
/* TIMER/COUNTER 0															 */
/* ------------------------------------------------------------------------- */

// Clock Select Bit Description (page 105)
//--------------------------------------------------------------------------
//	CS02	CS01	CS00	Meaning                 IN/OUT
//--------------------------------------------------------------------------
//  0		0		0		No clock source / timer is off
//  0		0		1		No prescaling, CLK      8MHz/8 MHz
//	0		1		0		CLK/8	                8MHz/1 MHz
//	0		1		1		CLK/32	                8MHz/250 KHz
//	1		0		0		CLK/64                  8MHz/125 KHz
//	1		0		1		CLK/128                 8MHz/62500 Hz
//	1		1		0		CLK/256		            8MHz/31250 Hz
//	1		1		1		CLK/1024	            8MHz/7812.5 Hz

#define T0_N_0          0
#define T0_N_1          _BV(CS00)
#define T0_N_8          _BV(CS01)
#define	T0_N_64			_BV(CS02)
#define	T0_N_128		(_BV(CS02) | _BV(CS00))
#define	T0_N_256		(_BV(CS02) | _BV(CS01))
#define	T0_N_1024		(_BV(CS02) | _BV(CS01) | _BV(CS00))

#define TMR0_SET_N(N)   TCCR0 = ((TCCR0 & ~(_BV(CS02) | _BV(CS01) | _BV(CS00))) | T0_N_ ## N )
#define TMR0_OFF()      TMR0_SET_N(0)

/* ------------------------------------------------------------------------- */
/* TIMER/COUNTER 2															 */
/* ------------------------------------------------------------------------- */

// Clock Select Bit Description (page 157)
//----------------------------------------
//	CS22	CS21	CS20	Meaning
//----------------------------------------
//	0		0		0		No clock source / timer is off
//	0		0		1		No prescaling, F_CPU
//	0		1		0		F_CPU/8			    1 MHz
//	0		1		1		F_CPU/64		    125 KHz
//	1		0		0		F_CPU/256		    31250 Hz
//	1		0		1		F_CPU/1024		    7812.5 Hz

#define	T2_N_0          0
#define	T2_N_1			_BV(CS20)
#define	T2_N_8			_BV(CS21)
#define	T2_N_64			(_BV(CS21) | _BV(CS20))
#define	T2_N_256		_BV(CS22)
#define	T2_N_1024		(_BV(CS22) | _BV(CS20))

#define TMR2_SET_N(N)	TCCR2 = ((TCCR2 & ~(_BV(CS22) | _BV(CS21) | _BV(CS20))) | T2_N_ ## N )
#define TMR2_OFF()		TMR2_SET_N(0)

#elif defined (__AVR_ATmega1281__)

/* ------------------------------------------------------------------------- */
/* TIMER/COUNTER 0                                                           */
/* ------------------------------------------------------------------------- */

#define T0_N_0          0
#define T0_N_1          _BV(CS00)
#define T0_N_8          _BV(CS01)
#define T0_N_64         (_BV(CS01) | _BV(CS00))
#define T0_N_256        _BV(CS02)
#define T0_N_1024       (_BV(CS02) | _BV(CS00))

/* Note: On ATmega1281, CS bits are in TCCR0B */
#define TMR0_SET_N(N)   TCCR0B = ((TCCR0B & ~(_BV(CS02) | _BV(CS01) | _BV(CS00))) | T0_N_ ## N )
#define TMR0_OFF()      TMR0_SET_N(0)

/* ------------------------------------------------------------------------- */
/* TIMER/COUNTER 2													         */
/* ------------------------------------------------------------------------- */

// Clock Select Bit Description (page 185)
//--------------------------------------------------------------------------
//	CS22	CS21	CS20	Meaning                 IN/OUT
//--------------------------------------------------------------------------
//  0		0		0		No clock source / timer is off
//  0		0		1		No prescaling, CLK      8MHz/8 MHz
//	0		1		0		CLK/8	                8MHz/1 MHz
//	0		1		1		CLK/32	                8MHz/250 KHz
//	1		0		0		CLK/64                  8MHz/125 KHz
//	1		0		1		CLK/128                 8MHz/62500 Hz
//	1		1		0		CLK/256		            8MHz/31250 Hz
//	1		1		1		CLK/1024	            8MHz/7812.5 Hz

#define T2_N_0          0
#define T2_N_1          _BV(CS20)
#define T2_N_8          _BV(CS21)
#define	T2_N_64			_BV(CS22)
#define	T2_N_128        (_BV(CS22) | _BV(CS20))
#define	T2_N_256		(_BV(CS22) | _BV(CS21))
#define	T2_N_1024		(_BV(CS22) | _BV(CS21) | _BV(CS20))

#define TMR2_SET_N(N)   TCCR2B = ((TCCR2B & ~(_BV(CS22)|_BV(CS21)|_BV(CS20))) | T2_N_ ## N )
#define TMR2_OFF()      TMR2_SET_N(0)

/* ------------------------------------------------------------------------- */
/* TIMER/COUNTER 4													         */
/* ------------------------------------------------------------------------- */

// Clock Select Bit Description (page 136/157)
//----------------------------------------
//	CS42	CS41	CS40	Meaning
//----------------------------------------
//	0		0		0		No clock source / timer is off
//	0		0		1		F_CPU, No prescaling
//	0		1		0		F_CPU/8
//	0		1		1		F_CPU/64
//	1		0		0		F_CPU/256
//	1		0		1		F_CPU/1024
//

#define	T4_N_0          0
#define	T4_N_1          _BV(CS40)                   // No prescaler
#define	T4_N_8          _BV(CS41)                   // F_CPU/8
#define	T4_N_64         (_BV(CS41) | _BV(CS40))     // F_CPU/64
#define	T4_N_256        _BV(CS42)                   // F_CPU/256
#define	T4_N_1024       (_BV(CS42) | _BV(CS40))     // F_CPU/1024

#define TMR4_SET_N(N)	TCCR4B = ((TCCR4B & ~(_BV(CS42)|_BV(CS41) |_BV(CS40))) | T4_N_ ## N )
#define TMR4_OFF()		TMR4_SET_N(0)

#else
#	error "Unsupported MCU"
#endif

/* ------------------------------------------------------------------------- */
/* TIMER/COUNTER 3															 */
/* ------------------------------------------------------------------------- */

// Clock Select Bit Description (page 136/157)
//----------------------------------------
//	CS32	CS31	CS30	Meaning
//----------------------------------------
//	0		0		0		No clock source / timer is off
//	0		0		1		F_CPU, No prescaling
//	0		1		0		F_CPU/8
//	0		1		1		F_CPU/64
//	1		0		0		F_CPU/256
//	1		0		1		F_CPU/1024
//

#define	T3_N_0      0
#define	T3_N_1		_BV(CS30)
#define	T3_N_8		_BV(CS31)
#define	T3_N_64		(_BV(CS31) | _BV(CS30))
#define	T3_N_256	_BV(CS32)
#define	T3_N_1024	(_BV(CS32) | _BV(CS30))

#define TMR3_SET_N(N)   TCCR3B = ((TCCR3B & ~(_BV(CS32)|_BV(CS31) |_BV(CS30))) | T3_N_ ## N )
#define TMR3_OFF()		TMR3_SET_N(0)

/* Fast PWM resolution modes: 8,9 or 10 bits */
#define TCCR3A_FPWM_8		_BV(WGM30)
#define TCCR3B_FPWM_8		_BV(WGM32)

#define TCCR3A_FPWM_9		_BV(WGM31)
#define TCCR3B_FPWM_9		_BV(WGM32)

#define TCCR3A_FPWM_10		(_BV(WGM31) | _BV(WGM30))
#define TCCR3B_FPWM_10		_BV(WGM32)

/* Selecting Fast PWM resolution with parameter */
#define TCCR3A_FPWM_N(n)	TCCR3A_FPWM_ ## n
#define TCCR3A_FPWM_(n)		TCCR3A_FPWM_N(n)

#define TCCR3B_FPWM_N(n)	TCCR3B_FPWM_ ## n
#define TCCR3B_FPWM_(n)		TCCR3B_FPWM_N(n)

/* Timer/Counter 3 TOP values for all Fast PWM resolutions */
#define TMR3_OCR_TOP_8		(0xFFU)
#define TMR3_OCR_TOP_9		(0x1FFU)
#define TMR3_OCR_TOP_10		(0x3FFU)

#define	TMR3_OCR_TOP_N(n)	TMR3_OCR_TOP_ ## n
#define	TMR3_OCR_TOP_(n)	TMR3_OCR_TOP_N(n)


#endif // _TIMERS_AVR_DEFINED
