orpaltech/dreamstalker/firmware/avrdreamstalkerpro/include/sound/vs1002_patch.h

/*
 * This file is part of the AVR Dreamstalker software
 * (https://github.com/orpaltech/dreamstalker).
 *
 * Copyright (c) 2013-2025	ORPAL Technologies, Inc.
 *
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
 * You should have received a copy of the GNU General Public License
 * along with this program. If not, see <http://www.gnu.org/licenses/>.
 */

//{
    /*revision*/
    0x81, 0x88,
    /* patch count */
    0x01, 0x00,

    /* --> patch 0 */
    /* instr count */
    0x35, 0x05,
    /* commands */
    0x07, 0x30, 0x80,
    0x06, 0x3f, 0x00,
    0x06, 0x8f, 0xff,
    0x06, 0x00, 0x00,
    0x06, 0xd7, 0x3b,
    0x06, 0x00, 0xf4,
    0x06, 0xc0, 0x55,
    0x06, 0x00, 0x00,
    0x06, 0xd7, 0x08,
    0x06, 0x00, 0xf4,
    0x06, 0xc0, 0x57,
    0x06, 0x00, 0x00,
    0x06, 0x24, 0x00,
    0x06, 0x00, 0x28,
    0x06, 0xc0, 0x73,
    0x06, 0x00, 0x00,
    0x06, 0x56, 0x00,
    0x07, 0x38, 0x80,
    0x06, 0x12, 0x3e,
    0x06, 0x01, 0xb8,
    0x06, 0x00, 0x00,
    0x06, 0x0a, 0x80,
    0x06, 0x92, 0x68,
    0x06, 0x02, 0x38,
    0x06, 0x02, 0xfe,
    0x06, 0x43, 0xb8,
    0x06, 0xbb, 0x48,
    0x06, 0xe5, 0xe4,
    0x06, 0x22, 0xfe,
    0x06, 0x4c, 0x18,
    0x06, 0xfa, 0x72,
    0x06, 0x4e, 0x38,
    0x06, 0xe6, 0xf0,
    0x06, 0x47, 0x41,
    0x06, 0xb2, 0x48,
    0x06, 0x0f, 0x38,
    0x06, 0x00, 0x00,
    0x06, 0xc4, 0x03,
    0x06, 0x46, 0xad,
    0x06, 0x0d, 0xb8,
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
    /* <-- patch 0 */
// }
