orpaltech/dreamstalker/firmware/avrdreamstalkerpro/src/sound/vs1002.cpp

/*
 * This file is part of the AVR Dreamstalker software
 * (https://github.com/orpaltech/dreamstalker).
 *
 * Copyright (c) 2013-2025	ORPAL Technologies, Inc.
 *
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
 * You should have received a copy of the GNU General Public License
 * along with this program. If not, see <http://www.gnu.org/licenses/>.
 */

#include <avr/io.h>
#include <avr/pgmspace.h>
#include <stdio.h>
#include <stdlib.h>
#include <string.h>
#include <util/delay.h>

#include "sound/vs10xx_mcu.h"
#include "sound/vs1002.h"

using namespace vlsi;

/*-----------------------------------------------------------------------*/
	/* SCI Registers */
#ifndef SCI_REG_MODE
#   define SCI_REG_MODE		0x00
#endif
#define  SM_OUTOFWAV	3			// Jump out of WAV decoding: 1 - yes
#define  SM_PDOWN		4			// Power down: 1 - yes
#define  SM_PLUSV		7			// MP3+V active: 1 - yes
#define  SM_ADPCM_HP	13			// ADPCM high-pass filter: 1 - active

/*-----------------------------------------------------------------------*/

/*
 * VS1002-specific default XTAL frequency and the clock doubler
 */
#define VS1002_XTAL_FREQ    24576000


#if ( VS_HW_SPEC == VS_HWS_1002 )

/*-----------------------------------------------------------------------*/

/* V1002 chip modifications */
#define VS1002_C	99
#define VS1002_D	100

#if !defined( VS1002_HW_REV )
	#define VS1002_HW_REV		VS1002_D
#endif

/*-----------------------------------------------------------------------*/

#if !defined( VS_XTAL_FREQ )
	#define VS_XTAL_FREQ		VS1002_XTAL_FREQ
#endif

#if (VS_XTAL_FREQ == 12288000)
	#define VS_USE_CLK_DBL	1
#elif (VS_XTAL_FREQ == VS1002_XTAL_FREQ)
	#define VS_USE_CLK_DBL	0
#else	
	#error Unsupported VS1002 crystal frequency
#endif

/*-----------------------------------------------------------------------*/

#if !defined( VS1002_IMA_ADPCM_PATCH )
	#define VS1002_IMA_ADPCM_PATCH	1
#endif

/*-----------------------------------------------------------------------*/
#define SC_FREQ(xf)		(((xf)/2000) & 0x7FF)	/* xf is XTAL frequency in Hz */

/*-----------------------------------------------------------------------*/

PROGMEM const uint8_t __vs1002_patch_rom[] = {
#include "sound/vs1002_patch.h"
};


/*-----------------------------------------------------------------------*/

#if ( VS1002_HW_REV == VS1002_C ) && ( VS1002_IMA_ADPCM_PATCH )
/* VS1002c ADPCM patch activation sequence */
vs_sci_instr_t patch_ima_adpcm_act [ 3 ] = {
		{ SCI_REG_WRAMADDR, 0x8021 },
		{ SCI_REG_WRAM,		0x2a01 },
		{ SCI_REG_WRAM,		0x000e },
};

static bool 
patch_ima_adpcm_set_act( vs_patch_t *patch, pvs_patch_state_t )
{
  /* Set activation instructions */
  patch->act.instr = patch_ima_adpcm_act;
  patch->act.num_instr = sizeof(patch_ima_adpcm_act) 
						/ sizeof(patch_ima_adpcm_act[0]);

  return true;
}
#endif

/*-----------------------------------------------------------------------*/
Vs1002::Vs1002()
{
}

vs_patch_rom_t *Vs1002::vs_patch_rom (void)
{
  return (pvs_patch_rom_t) __vs1002_patch_rom;
}

bool Vs1002::vs_process_patches( void )
{
/*#if ( VS1002_HW_REV == VS1002_D )
	if (! vs_patch_process_rom (0, NULL, vs_patch_apply, NULL, NULL))
		return false;
#endif*/

  return true;
}

void Vs1002::set_clockf( void )
{
  uint16_t val;

  /* Set freq in case if NOT the default XTAL is used */
  if (VS_XTAL_FREQ != VS1002_XTAL_FREQ)
	val = SC_FREQ (VS_XTAL_FREQ);
  else
	val = 0;

  if (VS_USE_CLK_DBL)
	val |= 0x8000;

  sci_write ( SCI_REG_CLOCKF, val );
}

void Vs1002::vs_suspend (void)
{
  if (sci_is_set ( SCI_REG_MODE, _BV(SM_PDOWN)))
	return;	/* already suspended*/

  analog_pwr_down ();

  sci_add ( SCI_REG_MODE, _BV(SM_PDOWN));
}

void Vs1002::vs_resume (void)
{
  if (! sci_is_set ( SCI_REG_MODE, _BV(SM_PDOWN)))
	return;	/* not suspended*/

  sci_remove ( SCI_REG_MODE, _BV(SM_PDOWN));

  set_volume ( VS_VOL_DEFAULT, VS_VOL_DEFAULT );
}

bool Vs1002::vs_playback_start ( void )
{
  soft_reset ( 0, 0 );

  /* Set clock after software reset */
  set_clockf ();

  return true;
}

void Vs1002::vs_playback_stop (void)
{
}

#if ( VS1002_IMA_ADPCM_PATCH )	

/*
 * Capture with ADPCM patch applied 
 */

bool Vs1002::vs_adpcm_rec_start (uint16_t sample_rate, uint8_t gain, bool highpass_filter)
{
  uint16_t div;

#if ( VS1002_HW_REV == VS1002_D )
	
  soft_reset ( 0, 0 );

  patch_process_rom ( vs_patch_rom(), 0, NULL, NULL, NULL );
#endif

  /* Set clock after software reset */
  set_clockf ();
	
  /* Write a clock divider value, div, can be obtained by formula below:
   * Fs = (2 * Fc) / (256 * div), where
   * 		2	- 	multiplier used only if clock doubler is in use;
   *		Fc	-	Xtal frequency, i.e. 12288000 Hz;
   *		fs	-	sampling rate, i.e. 8000 Hz;
   * i.e. with div=12, Fs = (2 * 122880000) / (256 * 12) = 8000 Hz
   */
  div = ((VS_USE_CLK_DBL ? 2UL : 1UL) * VS_XTAL_FREQ) / (256UL * sample_rate);

  // Set the Sample Rate divider 
  sci_write ( SCI_REG_AICTRL0, div );

  if ( gain == 0 ) {
	// Use Automatic Gain Control (AGC)
    sci_write ( SCI_REG_AICTRL1, AICTRL1_AGC );
	
    /* Set Maximum AGC Gain Ceiling (AICTRL2)
     * 0 = 64x (too loud, causes initial distortion/hiss)
     * 1024 = 1x
     * 4096 = 4x (Recommended: clear voice, low distortion)
     */
    sci_write ( SCI_REG_AICTRL2, AICTRL1_GAIN(4) ); 

  } else {
  	/* Set linear recording gain control, 1024 is equal to gain 1, 512 - gain 0.5, etc.
     *	The maximum value 65535, i.e.0xFFFF, is equal to gain 64.
     *	Write 0 to use automatic gain control (AGC)
     */
  	sci_write ( SCI_REG_AICTRL1, AICTRL1_GAIN(gain));
  }

#if ( VS1002_HW_REV == VS1002_C )
	/* By adding SM ADPCM flag during the software reset
	 * the user will activate IMA ADPCM recording mode.
	 */
	soft_reset ((highpass_filter ? _BV(SM_ADPCM_HP) : 0) | _BV(SM_ADPCM), 0);

	/* Set clock after software reset */
	set_clockf ();

	/* Write sample rate */
	sci_write ( SCI_REG_AUDATA, sample_rate );

	_delay_us (100);

	/* Load and start ADPCM recording patch */
	if (! patch_process_rom ( vs_patch_rom(), 0, NULL, 
						patch_ima_adpcm_set_act, NULL))
		return false;

#elif ( VS1002_HW_REV == VS1002_D )

  /* Activate ADPCM recording patch */
  sci_write ( SCI_REG_AIADDR, 0x30 );
#endif

  return true;
}

void Vs1002::vs_adpcm_rec_stop (void)
{
#if ( VS1002_HW_REV == VS1002_C )
  /* Software reset to disable ADPCM recording */
  soft_reset ( 0, _BV(SM_ADPCM) | _BV(SM_ADPCM_HP));

#elif ( VS1002_HW_REV == VS1002_D )
  sci_write ( SCI_REG_AIADDR, 0 );

  soft_reset ( 0, 0 );
#endif
}

#else

/* 
 * Otherwise go without ADPCM patch
 */

bool Vs1002::vs_adpcm_rec_start( uint16_t sample_rate, uint8_t gain, bool highpass_filter )
{
	uint16_t div;

	set_clockf();

	/* write a clock divider value, div, can be obtained by formula below:
	 * Fs = (2 * Fc) / (256 * div), where
	 * 		2	- 	multiplier used only if clock doubler is in use;
	 *		Fc	-	Xtal frequency, i.e. 12288000 Hz;
	 *		fs	-	sampling rate, i.e. 8000 Hz;
	 * i.e. with div=12, Fs = (2 * 122880000) / (256 * 12) = 8000 Hz
	 */
	div = ((VS_USE_CLK_DBL ? 2UL : 1UL) * VS_XTAL_FREQ) / (256UL * sample_rate);

	/* Set clock divider */
	sci_write ( SCI_REG_AICTRL0, div );

	/* Set linear recording gain control, 1024 is equal to gain 1, 512 - gain 0.5, etc.
	 *	The maximum value 65535, i.e.0xFFFF, is equal to gain 64.
	 *	Write 0 to use automatic gain control (AGC)
	 */
	sci_write ( SCI_REG_AICTRL1, AICTRL1_GAIN(gain));
	
	/* By adding SM ADPCM flag during the software reset
	 * the user will activate IMA ADPCM recording mode.
	 */
	soft_reset ((highpass_filter ? _BV(SM_ADPCM_HP) : 0) | _BV(SM_ADPCM), 0);

	/* Write sample rate */
	sci_write ( SCI_REG_AUDATA, sample_rate );

	_delay_us(100);

	return true;
}

void Vs1002::vs_adpcm_rec_stop (void)
{
	/* Software reset to disable ADPCM recording */
	soft_reset ( 0, _BV(SM_ADPCM) | _BV(SM_ADPCM_HP));
}

#endif	// VS1002_IMA_ADPCM_PATCH

#endif	// VS_HW_SPEC == VS_HWS_1002
