orpaltech/dreamstalker/firmware/avrdreamstalkerpro/src/sound/vs1003.cpp

/*
 * This file is part of the AVR Dreamstalker software
 * (https://github.com/orpaltech/dreamstalker).
 *
 * Copyright (c) 2013-2026	ORPAL Technologies, Inc.
 *
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
 * You should have received a copy of the GNU General Public License
 * along with this program. If not, see <http://www.gnu.org/licenses/>.
 */

#include <stdio.h>
#include <stdlib.h>
#include <string.h>
#include <util/delay.h>
#include <avr/io.h>
#include <avr/pgmspace.h>

#include "sound/vs10xx_mcu.h"
#include "sound/vs1003.h"
#include "ds_sysclock.h"
#include "ds_util.h"


using namespace vlsi;
using namespace ds;

/*-----------------------------------------------------------------------*/
	/* SCI Registers */
#ifndef SCI_REG_MODE
  #define SCI_REG_MODE  0x00
#endif
#define  SM_OUTOFWAV	  3			// Jump out of WAV decoding: 1 - yes
#define  SM_PDOWN		    4			// Power down: 1 - yes
#define  SM_SETTOZERO2  7     // Set to zero: 0 - right, 1 - wrong
#define  SM_ADPCM_HP	  13		// ADPCM high-pass filter: 1 - active
#define  SM_LINE_IN     14    // ADPCM source selector: 0 - mic, 1 - line

/*-----------------------------------------------------------------------*/

/*
 * VS1003-specific default XTAL frequency and the clock doubler
 */
#define VS1003_XTAL_FREQ    12288000


#if ( VS_HW_SPEC == VS_HWS_1003 )

/*-----------------------------------------------------------------------*/

#if !defined( VS_XTAL_FREQ )
  #define VS_XTAL_FREQ  VS1003_XTAL_FREQ
#endif

/*-----------------------------------------------------------------------*/

/* SCI_REG_CLOCKF - VS1003 specific bits */

/* SC_MULT - Bits 15:13 - Clock multiplier */
#define SC_MULT_1		  0x0000			/* XTALI */
#define SC_MULT_1P5		0x2000			/* XTALI×1.5 */
#define SC_MULT_2		  0x4000			/* XTALI×2.0 */
#define SC_MULT_2P5		0x6000			/* XTALI×2.5 */
#define SC_MULT_3		  0x8000			/* XTALI×3.0 */
#define SC_MULT_3P5		0xA000			/* XTALI×3.5 */
#define SC_MULT_4		  0xC000			/* XTALI×4.0 */
#define SC_MULT_4P5		0xE000			/* XTALI×4.5 */

/* SC_ADD - Bits 12:11	- tells how much the decoder firmware is allowed
 * to add to the multiplier specified by SC_MULT if more cycles are
 * temporarily needed to decode a WMA stream */
#define SC_ADD_0		  0x0000			/* No modification is allowed */
#define SC_ADD_0P5		0x0800			/* 0.5× */
#define SC_ADD_1		  0x1000			/* 1.0× */
#define SC_ADD_1P5		0x1800			/* 1.5× */

/* SC_FREQ - Bits 10:0	- is used to tell if the XTAL clock is running
 * at something else than 12.288 MHz. 
 */
#define SC_FREQ(xf)		((((xf)-8000000)/4000) & 0x7FF)		/* xf is XTAL frequency in Hz */


/*-----------------------------------------------------------------------*/

PROGMEM const uint8_t __vs1003_patch_rom[] = {
#include "sound/vs1003_patch.h"
};

/*-----------------------------------------------------------------------*/
Vs1003::Vs1003()
{
}

vs_patch_rom_t *Vs1003::vs_patch_rom (void)
{
  return (pvs_patch_rom_t) __vs1003_patch_rom;
}

void Vs1003::vs_suspend (void)
{
  if (sci_is_set ( SCI_REG_MODE, _BV(SM_PDOWN)))
	  return;	// already suspended

  analog_pwr_down ();

  sci_add ( SCI_REG_MODE, _BV(SM_PDOWN));
}

void Vs1003::vs_resume (void)
{
  if (! sci_is_set ( SCI_REG_MODE, _BV(SM_PDOWN)))
	  return;	// not suspended

  sci_remove ( SCI_REG_MODE, _BV(SM_PDOWN));

  set_volume ( VS_VOL_DEFAULT, VS_VOL_DEFAULT );
}

void Vs1003::set_clockf ( uint16_t mult, uint16_t add )
{
  uint16_t val = 0;

  /* Set freq in case if NOT the default XTAL is used */
  if (VS_XTAL_FREQ != VS1003_XTAL_FREQ)
 	  val |= SC_FREQ(VS_XTAL_FREQ);

  val |= mult;
  val |= add;

  sci_write ( SCI_REG_CLOCKF, val );
}

bool Vs1003::vs_playback_start (void)
{
  soft_reset ( 0, 0 );

  /* Set clock after software reset
   */
  set_clockf ( SC_MULT_2, SC_ADD_1 );

  return true;
}

void Vs1003::vs_playback_stop (void)
{
  // TODO: see if i should have here the same logic as for VS1053
}

/**
 * Starts the IMA ADPCM recording engine on the VS1003.
 * * NOTE ON STABILITY:
 * This function includes critical timing delays: Before soft_reset(), 
 * a 500ms delay is required to allow the Analog Bias and ADC stages 
 * to stabilize. Without this, the first few seconds of audio are 
 * dropped/silent as the DSP fails to sync.
 */
bool Vs1003::vs_adpcm_rec_start ( uint16_t sample_rate, uint8_t gain, bool highpass_filter )
{
  // Boost clock speed for high-speed DSP encoding (4x)
  set_clockf ( SC_MULT_4, SC_ADD_0 );

  /* Write a clock divider value, div, can be obtained by formula below:
   * Fs = (Mu * Fc) / (256 * div), where
   * 		Mu	- 	multiplier used only if clock doubler is in use;
   *		Fc	-	Xtal frequency, i.e. 12288000 Hz;
   *		Fs	-	sampling rate, i.e. 8000 Hz;
   * i.e. with div=12, Mu=2, 
   * 		Fs = (2 * 122880000) / (256 * 12) = 8000 Hz
   */
  uint16_t div = (4UL * VS_XTAL_FREQ) / (256UL * sample_rate);
  sci_write ( SCI_REG_AICTRL0, div );

	/* Set linear recording gain control, 1024 is equal to gain 1, 512 - gain 0.5, etc.
	 *	The maximum value 65535, i.e.0xFFFF, is equal to gain 64.
	 *	Write 0 to use automatic gain control (AGC)
	 */
  if ( gain == 0 ) {
    // Use Automatic Gain Control (AGC)
    sci_write ( SCI_REG_AICTRL1, AICTRL1_AGC );

    /* Set Maximum AGC Gain Ceiling (AICTRL2)
     * 0 = 64x (too loud, causes initial distortion/hiss)
     * 1024 = 1x
     * 4096 = 4x (Recommended: clear voice, low distortion)
     */
    sci_write ( SCI_REG_AICTRL2, AICTRL1_GAIN(4) ); 

  } else {
	  // Set linear recording gain control
    sci_write ( SCI_REG_AICTRL1, AICTRL1_GAIN(gain) );
    sci_write ( SCI_REG_AICTRL2, 0 );
  }

  // It is recommended by VLSI to clear AICTRL3 before starting
  sci_write ( SCI_REG_AICTRL3, 0 );

  // Allow the PLL to lock and Analog Bias to stabilize.
  // This prevents the "First 1/3 data loss" issue seen in recordings.
  SysClock::get()->wait( 500 ); 

  /* By adding SM ADPCM flag during the software reset
   * the user will activate IMA ADPCM recording mode.
   */
  soft_reset ( _BV(SM_ADPCM) | (highpass_filter ? _BV(SM_ADPCM_HP) : 0), 0 );

  return true;
}

void Vs1003::vs_adpcm_rec_stop ( void )
{
  /* Software reset to disable ADPCM recording 
   */
  soft_reset ( 0, _BV(SM_ADPCM) | _BV(SM_ADPCM_HP));
}

#endif	// VS_HW_SPEC == VS_HWS_1003
