orpaltech/dreamstalker/firmware/avrdreamstalkerpro/src/sound/vs1053.cpp

/*
 * This file is part of the AVR Dreamstalker software
 * (https://github.com/orpaltech/dreamstalker).
 *
 * Copyright (c) 2013-2025	ORPAL Technologies, Inc.
 *
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
 * You should have received a copy of the GNU General Public License
 * along with this program. If not, see <http://www.gnu.org/licenses/>.
 */

#include <stdio.h>
#include <stdlib.h>
#include <string.h>
#include <util/delay.h>
#include <avr/io.h>
#include <avr/pgmspace.h>

#include "sound/vs10xx_mcu.h"
#include "sound/vs1053.h"

using namespace vlsi;

/*-----------------------------------------------------------------------*/
	/* SCI Registers */
#ifndef SCI_REG_MODE
#   define SCI_REG_MODE		0x00
#endif
#define  SM_CANCEL      3           // Cancel decoding current file: 1 - cancel
#define  SM_EARSPK_LO   4           // EarSpeaker low setting: 1 - active
#define  SM_EARSPK_HI   7           // EarSpeaker high setting: 1 - active
#define  SM_LINE1       14          // MIC / LINE1 selector: 1 - LINE1
#define  SM_CLK_RANGE   15          // Input clock range: 0 - 12..13 MHz, 1 - 24..26 MHz

/*-----------------------------------------------------------------------*/

/*
 * VS1053-specific default XTAL frequency and the clock doubler
 */
#define VS1053_XTAL_FREQ    12288000


#if ( VS_HW_SPEC == VS_HWS_1053 )

/*-----------------------------------------------------------------------*/

#if !defined( VS_XTAL_FREQ )
#	define VS_XTAL_FREQ		VS1053_XTAL_FREQ
#endif

/*-----------------------------------------------------------------------*/

/*
 * AICTRL3 control flags
 */
#define AICTRL3_IMA_ADPCM	0x0000		/* Use IAM ADPCM format for recording */
#define AICTRL3_DUAL_CH		0x0001
#define AICTRL3_LEFT_CH		0x0002		/* Use left channel for recording */
#define AICTRL3_RIGHT_CH	0x0003		/* Use right channel for recording */
#define AICTRL3_LINEAR_PCM	0x0004		/* Use Linear PCM format for recording */

/* SCI_REG_CLOCKF - VS1053 specific bits */

/* SC_MULT - Bits 15:13 - Clock multiplier */
#define SC_MULT_1		0x0000U			/* XTALI */
#define SC_MULT_2		0x2000U			/* XTALI×2.0 */
#define SC_MULT_2P5		0x4000U			/* XTALI×2.5 */
#define SC_MULT_3		0x6000U			/* XTALI×3.0 */
#define SC_MULT_3P5		0x8000U			/* XTALI×3.5 */
#define SC_MULT_4		0xA000U			/* XTALI×4.0 */
#define SC_MULT_4P5		0xC000U			/* XTALI×4.5 */
#define SC_MULT_5		0xE000U			/* XTALI×5 */

/* SC_ADD - Bits 12:11	- tells how much the decoder firmware is allowed
 * to add to the multiplier specified by SC_MULT if more cycles are
 * temporarily needed to decode a WMA stream */
#define SC_ADD_0		0x0000U			/* No modification is allowed */
#define SC_ADD_1		0x0800U			/* 1.0×XTALI */
#define SC_ADD_1P5		0x1000U			/* 1.5×XTALI */
#define SC_ADD_2		0x1800U			/* 2.0×XTALI */

/* SC_FREQ - Bits 10:0	- is used to tell if the XTAL clock is running
 * at something else than 12.288 MHz
 */
#define SC_FREQ(xf)		((((xf)-8000000)/4000) & 0x7FF)		/* xf is XTAL frequency in Hz */


/*-----------------------------------------------------------------------*/

PROGMEM const uint8_t __vs1053_patch_rom[] = {
#include "sound/vs1053_patch.h"
};

/*-----------------------------------------------------------------------*/
Vs1053::Vs1053()
{
}

vs_patch_rom_t *Vs1053::vs_patch_rom ( void )
{
  return (pvs_patch_rom_t) __vs1053_patch_rom;
}

bool Vs1053::vs_playback_start ( void )
{
  soft_reset ( 0, 0 );

  /* Set clock after software reset */
  set_clockf ( SC_MULT_2, SC_ADD_1 );

  return true;
}

void Vs1053::vs_playback_stop ( void )
{
  // Read the endFillByte from VS1053 WRAM
  // The address 0x1e06 is the official location for the fill byte
  sci_write ( SCI_REG_WRAMADDR, 0x1e06 );
  uint16_t fill_val = sci_read ( SCI_REG_WRAM ) & 0xFF;
  uint8_t fill_byte = (uint8_t)fill_val;

  // Send 2052 bytes of endFillByte to SDI
  // This pushes the "real" audio out of the internal DAC FIFO
  uint8_t buffer[SDI_BLOCK_LEN];
  memset ( buffer, fill_byte, SDI_BLOCK_LEN);
    
  for (uint16_t i = 0; i < 65; i++) { // 65 * 32 = 2080 bytes
    sdi_write(buffer);
  }

  // Set SM_CANCEL bit
  sci_add ( SCI_REG_MODE, _BV(SM_CANCEL));

  // Send fill bytes while SM_CANCEL is still high
  // The chip clears SM_CANCEL when it has successfully aborted
  uint8_t timeout = 0;
  while (sci_is_set (SCI_REG_MODE, _BV(SM_CANCEL)) && timeout < 50) {
    sdi_write(buffer);
    _delay_ms(1);
    timeout++;
  }

  // If it didn't cancel, do a soft reset
  if (timeout >= 50) {
    soft_reset ( 0, 0 );
  }
}

bool Vs1053::vs_adpcm_rec_start ( uint16_t sample_rate, uint8_t gain, bool highpass_filter )
{
  // Configure Clock (Multiplier 4.5x)
  set_clockf ( SC_MULT_4P5, SC_ADD_0 );

  sci_write ( SCI_REG_AICTRL0, sample_rate );

  // 3. Gain & AGC Protection
  if ( gain == 0 ) {
    // Use Automatic Gain Control (AGC)
    sci_write ( SCI_REG_AICTRL1, AICTRL1_AGC );

    /* Set Maximum AGC Gain Ceiling (AICTRL2)
     * 0 = 64x (too loud, causes initial distortion/hiss)
     * 1024 = 1x
     * 4096 = 4x (Recommended: clear voice, low distortion)
     */
    sci_write ( SCI_REG_AICTRL2, AICTRL1_GAIN(4) ); 

  } else {
    /* Set linear recording gain control, 1024 is equal to gain 1, 512 - gain 0.5, etc.
     *	The maximum value 65535, i.e.0xFFFF, is equal to gain 64.
     *	Write 0 to use automatic gain control (AGC)
     */
    sci_write ( SCI_REG_AICTRL1, AICTRL1_GAIN(gain) );
    sci_write ( SCI_REG_AICTRL2, 0 ); // Ignored
  }

  // Format selection
  sci_write ( SCI_REG_AICTRL3, AICTRL3_IMA_ADPCM | AICTRL3_LEFT_CH );

  // NOTE: DO NOT set the software reset bit. The patch below will do it
  soft_reset ( _BV(SM_ADPCM), _BV(SM_LINE1) );

  /* This patch rewrites the SRC interrupt vector and restarts the firmware, so the patch 
   *	must be loaded after the encoding parameters have been set in AICTRL0.. AICTRL3, 
   *	and the ADPCM bit has been set in SCI_MODE (without setting the software reset bit).
   */
  patch_process_rom ( vs_patch_rom(), 0, NULL, NULL, NULL );

  return true;
}

void Vs1053::vs_adpcm_rec_stop ( void )
{
  /* Software reset to disable ADPCM recording */
  soft_reset ( 0, _BV(SM_ADPCM) );
}

void Vs1053::set_clockf ( uint16_t mult, uint16_t add )
{
  uint16_t val = 0;

  if (VS_XTAL_FREQ >= 24000000) {
	  sci_add ( SCI_REG_MODE, _BV(SM_CLK_RANGE));
  }

  /* Set freq in case if NOT the default XTAL is used */
  if (VS_XTAL_FREQ != VS1053_XTAL_FREQ)
 	  val |= SC_FREQ(VS_XTAL_FREQ);

  val |= mult;
  val |= add;

  sci_write ( SCI_REG_CLOCKF, val );
}

void Vs1053::vs_suspend (void)
{
  /* 1 - write 0x0000 to SCI_CLOCKF. This disables PLL and saves power*/
  sci_write ( SCI_REG_CLOCKF, 0x0000 );

  /* 2 - write a low non-zero value, such as 0x0010 to SCI_AUDATA*/
  sci_write ( SCI_REG_AUDATA, 0x0010 );

  /* 3 - power down analog drivers */
  analog_pwr_down ();
}

void Vs1053::vs_resume (void)
{
  /* same as in vs1053_suspend() but in reverse order */

  /* 3 - set vol thus enabling analog drivers */
  set_volume ( VS_VOL_DEFAULT, VS_VOL_DEFAULT );

  /* 2 */
  // TODO: implement

  /* 1 - enable clock */
  set_clockf ( SC_MULT_2, SC_ADD_1 );
}

#endif	// VS_HW_SPEC == VS_HWS_1053
