orpaltech/dreamstalker/firmware/avrdreamstalkerpro/include/ds_remdetect.h

/*
 * This file is part of the AVR Dreamstalker software
 * (https://github.com/orpaltech/dreamstalker).
 *
 * Copyright (c) 2013-2026	ORPAL Technologies, Inc.
 *
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
 * You should have received a copy of the GNU General Public License
 * along with this program. If not, see <http://www.gnu.org/licenses/>.
 */

#ifndef _DS_REMD_DEFINED
#define _DS_REMD_DEFINED

#include <stdbool.h>
#include <stdint.h>

#include <core/adc_avr.h>
#include "ds_lowpass.h"
#include "ds_util.h"

#define REMD_LOG_FILE 1   // log to a file
#define REMD_LOG_UART 2   // log to serial port

namespace ds::remd
{
/*-----------------------------------------------------------------------*/

typedef enum e_remd_event_type {
  REMD_EVENT_MOVE = 1,
	REMD_EVENT_REM = 2,
} remd_event_type_t;

/*-----------------------------------------------------------------------*/
typedef void (*REMDetectCB_t)(void *context, remd_event_type_t event, uint16_t arg);

/*-----------------------------------------------------------------------*/
class Detector {
public:
  static Detector *get();

  enum class State {
    Off = 1,  // Stopped
    Starting, // Start requested
    On,       // Started
    Stopping  // Stop requested
  };

  bool init (void) ;
  void end (void);

  bool start (REMDetectCB_t premdcb, void *context, bool check_mode);
  void stop (void) ;
  State get_state (void) const;
  bool is_check_mode (void) const;

  /* Must be called in the main application loop */
  void process_task (void);

protected:
  void on_a2d_sample(uint16_t sample);

  bool start_internal (void);
  void stop_internal (void);

private:
  static void a2d_sample_callback(void *context, uint16_t sample);
  
  void process_sample(int16_t sample);
  void log_epoch(uint16_t moves, uint16_t ceiling, uint16_t restlessness,
                uint16_t peak, uint8_t rem_epochs, uint8_t trigger);

private:
  REMDetectCB_t pcb_func;
  void *pcb_context;
  bool check_mode;
  volatile State state;

  LowPassFilter lowpass_flt;

typedef struct s_remd_context {
    /* --- 30-Second Epoch Decision Logic --- */
    uint16_t move_count;         // Number of validated eye rolls in the current 30s window
    uint32_t epoch_samples;      // Sample counter to track the 30s window (30,000 @ 1000Hz)
    uint16_t current_epoch;      // Master timeline index (increments every 30s)
    uint8_t  rem_epoch_count;    // Leaky Bucket integrator (increments on REM, drains on quiet)
    uint16_t last_trigger_epoch; // Timestamp of the last LED flash to manage cooldowns
    uint32_t epoch_total_delta;  // Cumulative jitter sum used to calculate 'variability'

    /* --- 50ms Integration Bucket (Filter) --- */
    int32_t  bucket_sum;         // Accumulator for the current 50 samples
    uint16_t bucket_count;       // Counter for the current 50ms bucket (0 to 49)
    int16_t  last_avg;           // The integrated average of the previous 50ms bucket
    
    /* --- Saccade (Eye Movement) Detection --- */
    uint16_t move_duration;      // Width of current movement (in 50ms bucket units)
    int16_t  move_peak_delta;    // Highest jitter seen within the CURRENT movement burst
    int16_t  epoch_peak_delta;   // Highest jitter seen across the WHOLE 30s epoch (for logs)

    /* --- Output & Triggering --- */
    uint8_t  trigger_cycle;      // Intensity step counter (0=Subtle, 1=Med, 2=Strong)
  } remd_context_t;

#define REMD_EPOCH_MAGIC  0xAA55
  typedef struct __attribute__((packed)) s_remd_epoch_stats {
    uint16_t magic;             // The value of REMD_EPOCH_MAGIC
    uint16_t epoch_index;       // Time/Index
    uint16_t move_count;        // Saccades counted
    uint16_t gate_ceiling;      // The Blink Filter height (from sensitivity)
    uint16_t restlessness;      // The variability (shakiness)
    uint16_t epoch_peak_delta;  // The strongest single move seen
    uint8_t  rem_epoch_count;   // Current level of the Leaky Bucket (Integrator)
    uint8_t  trigger_status;    // LED intensity (0, 15, 20, 30)
  } remd_epoch_stats_t;

  typedef struct __attribute__((packed)) s_remd_epoch_config {
    uint16_t magic;           // The value of REMD_EPOCH_MAGIC
    uint32_t start_time;      // The start time, in linux format
    uint8_t profile;          // The profile used 
  } remd_epoch_config_t;

  remd_context_t remd;

  typedef struct s_remd_stats_buffer {
#define STATS_BUFF_LEN  4
    remd_epoch_stats_t data[STATS_BUFF_LEN];
    uint8_t write_idx;  // Where the ISR puts data
    uint8_t read_idx;   // Where the Main Loop reads data
    bool overrun;
  } remd_stats_buffer_t;

  volatile remd_stats_buffer_t stats_buff;
  String stats_filepath;

#if REMD_LOG == REMD_LOG_FILE // log to file
public:
  typedef struct s_remd_sample_log {
#define LOG_BUFF_SIZE 256
    uint16_t buf[LOG_BUFF_SIZE];
    int buf_idx;
    bool buf_ready;
  } remd_sample_log_t;

  File slog_fp;
  uint16_t slog_fp_buf[LOG_BUFF_SIZE];
  volatile remd_sample_log_t slog;
#endif
};

/*-----------------------------------------------------------------------*/
} //namespace ds::remd

#endif // _DS_REMD_DEFINED
