orpaltech/dreamstalker/firmware/avrdreamstalkerpro/include/core/adc_avr.h

/*
 * This file is part of the AVR Dreamstalker software
 * (https://github.com/orpaltech/dreamstalker).
 *
 * Copyright (c) 2013-2026	ORPAL Technologies, Inc.
 *
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
 * You should have received a copy of the GNU General Public License
 * along with this program. If not, see <http://www.gnu.org/licenses/>.
 */

#ifndef _AVR_A2DC_DEFINED
#define _AVR_A2DC_DEFINED

#include <stdbool.h>
#include <avr/power.h>


namespace avr::core
{
/*-----------------------------------------------------------------------*/
typedef void (*A2DSampleCB_t)(void *context, uint16_t sample);

/*-----------------------------------------------------------------------*/
class A2DConvert {
public:
  static A2DConvert *get();

  enum Channels : uint8_t {
    CHAN_0 = 0,
    CHAN_2 = 2
  };

  enum ChannelFlags : uint16_t {
    CF_NONE         = 0,
    CF_VREF_2_56    = 1,
    CF_LEFT_ADJUST  = 2,
  };

  static constexpr uint8_t MAX_CHANNELS = 2;
  static constexpr uint16_t MAX_VALUE = 0x3FFU;  // 10bit

public:
  bool enable (void) ;
  void disable (void) ;

  void warm_up ( void);

  bool setup_channel (uint8_t chan, uint16_t flags = CF_NONE);
  bool start (uint8_t chan, uint16_t num_samples, A2DSampleCB_t pfcb = nullptr, void *context = nullptr);
  void stop (uint8_t chan) ;
  void enable_channel (uint8_t chan, bool enable);

  bool start_unsafe (uint8_t chan, uint16_t num_samples, A2DSampleCB_t pfcb = nullptr, void *context = nullptr);
  void stop_unsafe (uint8_t chan) ;

  static uint32_t get_adc_rate (void);

  /* Intended for use in system clock ISR only */
  static void handle_sysclk (void);
  static void handle_adc (void);

private:
  int8_t  get_index( uint8_t chan ) const;
  int8_t  get_next_running_index (int8_t current_index) const;
  int8_t  get_first_running_index ( void) const;
  void  convert_one ( int8_t index ) const;
  void  sysclk_handler ( void);
  void  adc_handler ( void);
  
private:
  typedef struct s_adc_context {
    uint8_t channel;
    uint8_t flags;
    uint16_t num_samples;
    A2DSampleCB_t pfcb;
    void *context;
  } adc_context_t;
  
  volatile adc_context_t adc[MAX_CHANNELS];
};

/*-----------------------------------------------------------------------*/
} //avr::core

#endif // _AVR_A2DC_DEFINED
