orpaltech/dreamstalker/firmware/avrdreamstalkerpro/include/sound/ds_tonegen.h

/*
 * This file is part of the AVR Dreamstalker software
 * (https://github.com/orpaltech/dreamstalker).
 *
 * Copyright (c) 2020-2026	ORPAL Technologies, Inc.
 *
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
 * You should have received a copy of the GNU General Public License
 * along with this program. If not, see <http://www.gnu.org/licenses/>.
 */

#ifndef _DS_TONEGEN_DEFINED
#define _DS_TONEGEN_DEFINED

#include <stdint.h>
#include <stdbool.h>

namespace ds
{
/*-----------------------------------------------------------------------*/
typedef enum e_tonegen_piece {
  TGP_NONE = 0,
  /*
   * Classical
   */
  TGP_MOONLIGHT_SONATA,
  TGP_BEETHOVEN_FUR_ELISE,
  TGP_BEETHOVEN_ODE_TO_JOY,
  TGP_KLEINE_NACHTMUSIK,

  /*
   * Popular Songs
   */
  TGP_JINGLE_BELLS,
  TGP_HAPPY_BIRTHDAY,
  TGP_AMAZING_GRACE,

  /*
   * Movie Soundtracks
   */
  TGP_INDIANA_JONES,
  TGP_MISSION_IMPOSSIBLE,

} tonegen_piece_t;

/*-----------------------------------------------------------------------*/

class Tonegen {
public:
  static Tonegen *get();
public:
  void init (void);
  void end (void) {}

  void beep (uint32_t millisec, uint8_t note, uint8_t octave, uint8_t volume);
  /**
   * piece        : melody to play
   * repeat_count : 0 - unlimited
   */
  bool play_melody (tonegen_piece_t piece, uint8_t repeat_count);
  bool is_playing (void) const;
  void stop (void);

  void set_intensity(uint16_t intensity, uint16_t max_intensity);

  /* Unsafe operations (must be called from ISR)*/
  void beep_unsafe (uint32_t millisec, uint8_t note, uint8_t octave, uint8_t volume);
  bool play_melody_unsafe (tonegen_piece_t piece, uint8_t repeat_count);
  bool is_playing_unsafe (void) const;
  void stop_unsafe (void);

  /* Intended for use in RTC ISR only. Do not call it directly! */
  static void handle_isr (void);

private:
  void irq_handler (void);
  
  char melody_get_char (void);

  typedef struct s_tonegen_melody {
    const char *head;
    const char *buffer;
    uint8_t storage_mode : 2; /* where a melody is stored */
    uint32_t ticks;
    uint16_t duration;        /* duration of current note */
    uint16_t whole_duration;  /* duration of whole note */
    uint8_t note_default_len;
    uint8_t octave_default;
    /* use count to designate melody/beep,
    * count = 0 - idle
    * count < 0 - beep
    * count > 0 - melody
    */
    int16_t count;
  } tonegen_melody_t;

  volatile tonegen_melody_t melody;
  uint16_t tone_icr_base;
};

/*-----------------------------------------------------------------------*/
} //ds

#endif  // _DS_TONEGEN_DEFINED
