orpaltech/dreamstalker/tools/qtdreamflowmanager/main.cpp

#include "managermainwindow.h"

#include <QApplication>
#include <QLocale>
#include <QTranslator>
#include <QScreen>

int main(int argc, char *argv[])
{
    QApplication app(argc, argv);

    QTranslator translator;
    const QStringList uiLanguages = QLocale::system().uiLanguages();
    for (const QString &locale : uiLanguages) {
        const QString baseName = "QtDreamstalkerManager_" + QLocale(locale).name();
        if (translator.load(":/i18n/" + baseName)) {
            app.installTranslator(&translator);
            break;
        }
    }

    QScreen *screen = QGuiApplication::primaryScreen();
    QRect  screenGeometry = screen->geometry();
    int height = screenGeometry.height();
    int width = screenGeometry.width();

    QManagerMainWindow w;
    w.resize(width*0.8, height*0.7);
    w.show();
    return app.exec();
}
