orpaltech/dreamstalker/tools/qtdreamflowmanager/managermainwindow.h

#ifndef MANAGERMAINWINDOW_H
#define MANAGERMAINWINDOW_H

#include <QMainWindow>
#include <QSerialPort>

/****************************************************/

QT_BEGIN_NAMESPACE
namespace Ui {
class ManagerMainWindow;
}
QT_END_NAMESPACE

/****************************************************/

QT_FORWARD_DECLARE_CLASS(QLabel)
QT_FORWARD_DECLARE_CLASS(QFile)
QT_FORWARD_DECLARE_CLASS(QCommSettingsDialog)
QT_FORWARD_DECLARE_CLASS(QCaptureSettingsDialog)
QT_FORWARD_DECLARE_CLASS(QRemDDataSource)

/****************************************************/

class QManagerMainWindow : public QMainWindow
{
    Q_OBJECT

public:
    QManagerMainWindow(QWidget *parent = nullptr);
    ~QManagerMainWindow();

private slots:
    void about();
    void startDataCapture();
    void stopDataCapture();
    void onSerialData();
    void onSerialError(QSerialPort::SerialPortError error);
    void loadSamplesFromFile();
    void loadEpochsFromFile();
    void loadSamplesFromSerial();
    void toggleActiveWidget();
    void onDataSourceStopped(int error, const QString& message);


private:
    void initActionsConnections();
    void showStatusMessage(const QString &message);

    bool openSerialPort();
    void closeSerialPort();

    void createSamplesWidget(QRemDDataSource *dataSource);
    void deleteActiveWidget();

    void createEpochsWidget(QRemDDataSource *dataSource);

private:
    Ui::ManagerMainWindow *m_ui;
    QWidget     *m_activeWidget;
    QCommSettingsDialog *m_commSettings;
    QCaptureSettingsDialog *m_captureSettings;
    QSerialPort *m_serialPort;
    QFile       *m_outputDataFile;
    QLabel      *m_status;
};
#endif // MANAGERMAINWINDOW_H
