orpaltech/dreamstalker/tools/qtdreamflowmanager/remdepochswidget.h

#ifndef REMDEPOCHSWIDGET_H
#define REMDEPOCHSWIDGET_H

#include <QDateTime>
#include <QWidget>

/****************************************************/

QT_FORWARD_DECLARE_CLASS(QChart)
QT_FORWARD_DECLARE_CLASS(QChartView)
QT_FORWARD_DECLARE_CLASS(QLineSeries)
QT_FORWARD_DECLARE_CLASS(QScatterSeries)
QT_FORWARD_DECLARE_CLASS(QScrollBar)
QT_FORWARD_DECLARE_CLASS(QAbstractAxis)
QT_FORWARD_DECLARE_CLASS(QFrame)
QT_FORWARD_DECLARE_CLASS(QCheckBox)
QT_FORWARD_DECLARE_CLASS(QRemDEpochSeriesDevice)
QT_FORWARD_DECLARE_CLASS(QRemDDataSource)


/****************************************************/

class QRemDEpochsWidget : public QWidget
{
    Q_OBJECT
public:
    explicit QRemDEpochsWidget(QRemDDataSource *sourceEpochs, QWidget *parent = nullptr);
    ~QRemDEpochsWidget();

    void clearCharts();

protected:
    void resizeEvent(QResizeEvent *event) override;

private:
    void setupLayout();
    void resetZoom();
    void jumpToActivity();
    void updateAxisGrid(QAbstractAxis* axis, double minVal, double maxVal, bool isHorizontal);
    void updateCharts();
    QString getProfileNameFromId(int id);

private slots:
    void handleScroll(int value);
    void handleDataUpdated(double minX, double maxX, double peakTop, double peakBottom);
    void handleProfileResolved(int profileId);
    void handleStartTimeResolved(const QDateTime& startTime);

private:
    QChartView      *m_viewTop;
    QChartView      *m_viewBottom;
    QScrollBar      *m_scrollbar;

    // Top Chart Series
    QLineSeries     *m_seriesRestless;
    QLineSeries     *m_seriesVelocity;
    QLineSeries     *m_seriesCeiling; // The "Blink Filter" line

    // Bottom Chart Series
    QLineSeries     *m_seriesMoves;
    QLineSeries     *m_seriesBucket;  // The "Staircase" integrator
    QScatterSeries  *m_seriesTrigger;

    QFrame          *m_overlay;
    QCheckBox       *m_followCheck;

    QRemDDataSource         *m_sourceEpochs;
    QRemDEpochSeriesDevice  *m_epochsSeriesDevice;

    QDateTime   m_startTime;

    double m_minX;          // The very first epoch index (the start)
    double m_maxX;          // The latest epoch index received
    double m_maxYTop, m_maxYBottom;
    bool m_autoScroll;      // Toggle this to turn scrolling on/off
    int m_windowSize;       // Show the last 1000 epochs
    bool m_isFollowingLive;
};

#endif // REMDEPOCHSWIDGET_H
