orpaltech/dreamstalker/(commit log)

2019-08-25 Planned update
    [Dreamstalker-PRO-v1.kicad_pcb, Dreamstalker-PRO-v1.sch]
2019-09-08 Added Ultra
    [Dreamstalker-PRO-v1-B_Cu.gbr, Dreamstalker-PRO-v1-B_Mask.gbr, Dreamstalker-PRO-v1-B_Paste.gbr, Dreamstalker-PRO-v1-B_SilkS.gbr, Dreamstalker-PRO-v1-Edge_Cuts.gbr, Dreamstalker-PRO-v1-F_Cu.gbr, Dreamstalker-PRO-v1-F_Mask.gbr, Dreamstalker-PRO-v1-F_Paste.gbr]
2019-11-16 Dreamstalker-PRO PCB improvements
    [Dreamstalker-PRO-v1-B_Cu.gbr, Dreamstalker-PRO-v1-B_Mask.gbr, Dreamstalker-PRO-v1-B_Paste.gbr, Dreamstalker-PRO-v1-B_SilkS.gbr, Dreamstalker-PRO-v1-Edge_Cuts.gbr, Dreamstalker-PRO-v1-F_Cu.gbr, Dreamstalker-PRO-v1-F_Mask.gbr, Dreamstalker-PRO-v1-F_Paste.gbr]
2025-03-17 Add kicad pcb PRO v2
    [Dreamstalker-PRO-v2-B_Cu.gbr, Dreamstalker-PRO-v2-B_Fab.gbr, Dreamstalker-PRO-v2-B_Mask.gbr, Dreamstalker-PRO-v2-B_Paste.gbr, Dreamstalker-PRO-v2-B_Silkscreen.gbr, Dreamstalker-PRO-v2-Edge_Cuts.gbr, Dreamstalker-PRO-v2-F_Cu.gbr, Dreamstalker-PRO-v2-F_Fab.gbr]
2025-03-17 PRO: Update kicad files
2025-12-10 1) Fixed: battery monitor not able to detect low-battery state (Now get battery monitor signal from LDO input). 2) Other planned updates.
    [Dreamstalker-PRO-v2-B_Cu.gbr, Dreamstalker-PRO-v2-B_Fab.gbr, Dreamstalker-PRO-v2-B_Mask.gbr, Dreamstalker-PRO-v2-B_Paste.gbr, Dreamstalker-PRO-v2-B_Silkscreen.gbr, Dreamstalker-PRO-v2-Edge_Cuts.gbr, Dreamstalker-PRO-v2-F_Cu.gbr, Dreamstalker-PRO-v2-F_Fab.gbr]
2025-12-30 Tools: add console remd-sample receiver
2025-12-30 Set ADC sample rate to 1KHz for any number of running channels
2026-01-26 REM detection algorithm updates; ADPCM recording fix
    [ds_appmenu.cpp, ds_codec.cpp, ds_codec.h, ds_config.cpp, ds_config.h, ds_display.cpp, ds_driver.cpp]
2026-01-26 Remove unused files
    [Dreamstalker-Ultra-v1.kicad_pcb, Dreamstalker-Ultra-v1.sch]
2026-01-26 Kicad updates; Minor changes to sources
    [Dreamstalker-PRO-v2-B_Cu.gbr, Dreamstalker-PRO-v2-B_Fab.gbr, Dreamstalker-PRO-v2-B_Mask.gbr, Dreamstalker-PRO-v2-B_Paste.gbr, Dreamstalker-PRO-v2-B_Silkscreen.gbr, Dreamstalker-PRO-v2-Edge_Cuts.gbr, Dreamstalker-PRO-v2-F_Cu.gbr, Dreamstalker-PRO-v2-F_Fab.gbr]
2026-02-02 New REM detect algorithm; New visualization in qtdreamflowmanager; Lots of bugfix
    [Dreamstalker-PRO-v2.kicad_sch]
2026-08-15 Hardware: minor updates to kicad files
    [Dreamstalker-PRO-v2.kicad_pcb, Dreamstalker-PRO-v2.kicad_sch]
2026-08-16 Firmware: fixed battery monitor broken logic
    [ds_battery.cpp, ds_battery.h]
2026-08-16 Firmware: tiny refactoring in battery moniitor code
