orpaltech/dreamstalker/(notices)

Notices in the files:
firmware/avrdreamstalkerpro/include/sound/vs1002_patch.h:
This program is free software: you can redistribute it and/or modify
it under the terms of the GNU General Public License as published by
the Free Software Foundation, version 3.
hardware/kicad/PRO/Dreamstalker-PRO-v1/Dreamstalker-PRO-v1.kicad_pcb:
(C) 2013-2019 ORPALTECH
